open-headset-interconnect-standard/ohis/README.md

# Open-Headset-Interconnect-Standard

An open standard for a common interconnect between headsets and radios.
