open-headset-interconnect-standard/ohis/OHIS Presentation/Open Headset Interconnect Standard-2024.pdf

# Open

# Headset Interconne

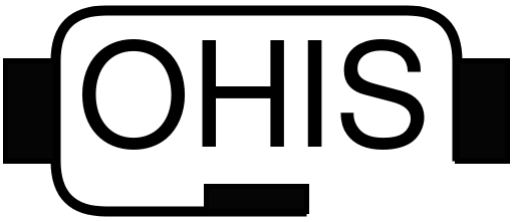
[picture p12: figure]

ct

# Standard

# Mark

Smith,

# N6MTS

https://ohis.org/

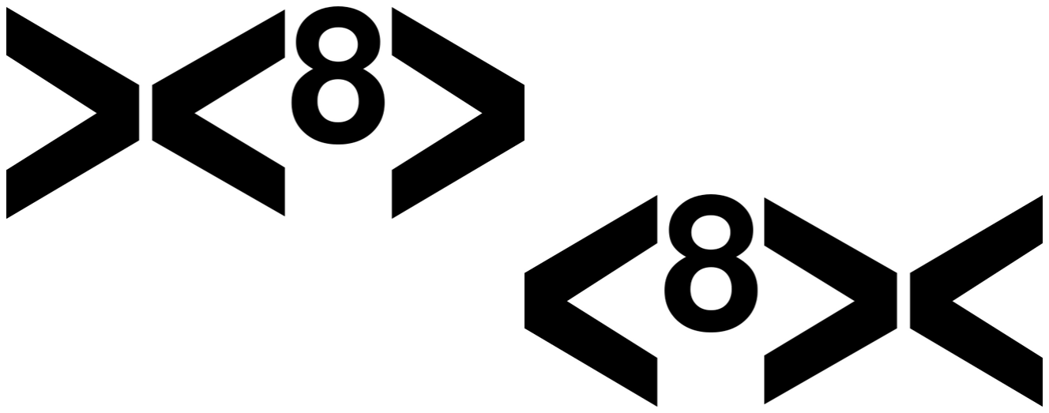
[picture p13: figure]

Video

# Who am I?

### Mark Smith, N6MTS

λ President/CEO, Halibut Electronics: https://electronics.halibut.com/

λ A host of the Ham Radio Workbench Podcast: https://www.hamradioworkbench.com/

λ YouTube: @SmittyHalibut

λ Mastodon/Fediverse: @smitty@halibut.com

Video

# Who am I?

### Mark Smith, N6MTS

λ President/CEO, Halibut Electronics: https://electronics.halibut.com/

λ A host of the Ham Radio Workbench Podcast: https://www.hamradioworkbench.com/

λ YouTube: @SmittyHalibut

λ Mastodon/Fediverse: @smitty@halibut.com

Head Cheese

Video

# Who am I?

λ Ham: Active ham since 1992.

λ College: Two years in Electrical Engineering, but degree in Computer Engineering, CalPoly San Luis Obispo

λ Work: ~30 years in IT, Network and Unix Systems Engineering, and Information Security.

λ All Three: Left IT in 2021, started Halibut Electronics to make Ham Radio and Audiophile electronics.

Video

# Open Headset Interconnect Standard

Video

# Open Headset Interconnect Standard

- Open: Any individual or company may make devices compliant with this standard, with no obligation.

Video

# Open Headset Interconnect Standard

- Open: Any individual or company may make devices compliant with this standard, with no obligation.
- Headset: Describes the signaling commonly found between a user and a radio: Microphone, Headphones, and Push To Talk.

Video

# Open Headset Interconnect Standard

- Open: Any individual or company may make devices compliant with this standard, with no obligation.
- Headset: Describes the signaling commonly found between a user and a radio: Microphone, Headphones, and Push To Talk.
- Interconnect: Describes both the physical and electrical connection of those signals between the user and radio.

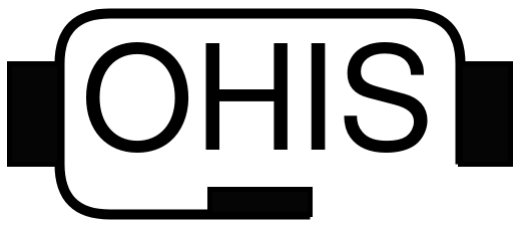
[picture p14: figure]

Video

# Open Headset Interconnect Standard

- Open: Any individual or company may make devices compliant with this standard, with no obligation.
- Headset: Describes the signaling commonly found between a user and a radio: Microphone, Headphones, and Push To Talk.
- Interconnect: Describes both the physical and electrical connection of those signals between the user and radio.
- Standard: Devices built to this standard will work with other devices built to the same standard.

Video

# Electrical Standards

We | have electrical standards (defined, or | de-facto) for
things like RF and Power:

Video

# Electrical Standards

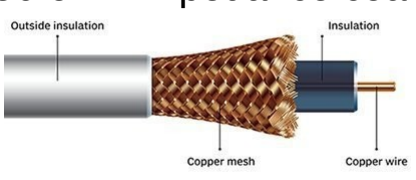
[picture p15: figure]

We | have electrical standards (defined, or | de-facto) for
things like RF and Power:

RF: 50 ohm impedance coax, 450 ohm twin lead

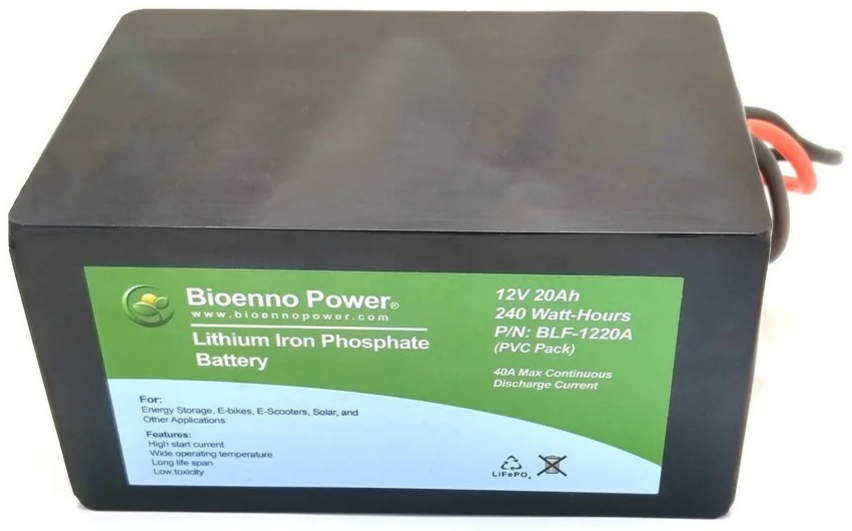
[picture p16: figure]

Video

# Electrical Standards

We | have electrical standards (defined, or | de-facto) for
things like RF and Power:

RF: 50 ohm impedance coax, 450 ohm twin lead

Power: +13.8vDC +/- 15%

Video

# Physical Standards

And one, or a few, physical standards that are easy to convert between:

Video

# Physical Standards

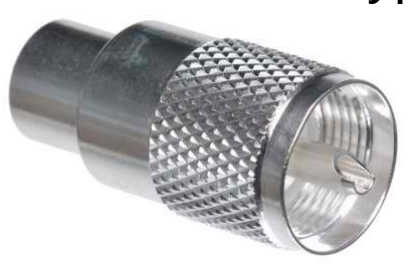
[picture p17: figure]
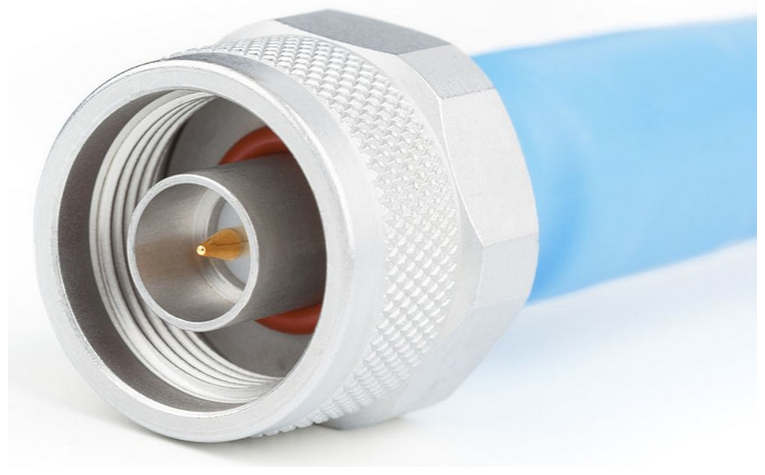
[picture p18: figure]
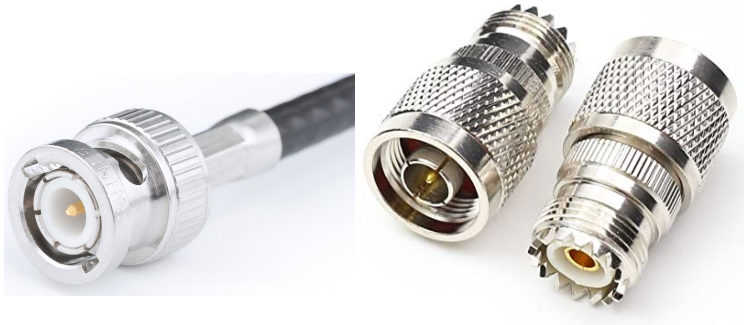
[picture p19: figure]

And one, or a few, physical standards that are easy to convert between:

λ RF: PL-259, Type N, BNC, etc

# Physical Standards

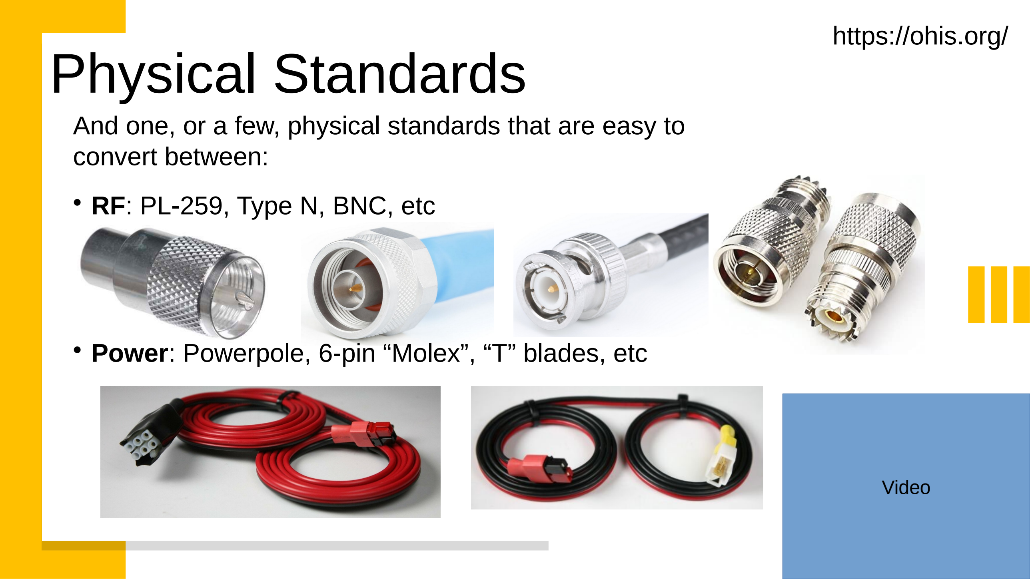
[picture p20: page 15]

Video

And one, or a few, physical standards that are easy to convert between:

λ RF: PL-259, Type N, BNC, etc

λ Power: Powerpole, 6-pin “Molex”, “T” blades, etc

Video

# Headset Standards?

No such electrical standards exist for the User to Radio interface:

Video

# Headset Standards?

No such electrical standards exist for the User to Radio interface:

- Microphone: Dynamic, Electret, or Carbon? Balanced or single ended?

Video

# Headset Standards?

No such electrical standards exist for the User to Radio interface:

- Microphone: Dynamic, Electret, or Carbon? Balanced or single ended?
- Audio out: Line level, headphone level, or speaker level? Ground referenced or push-pull? Mono or stereo?

Video

# Headset Standards?

No such electrical standards exist for the User to Radio interface:

- Microphone: Dynamic, Electret, or Carbon? Balanced or single ended?
- Audio out: Line level, headphone level, or speaker level? Ground referenced or push-pull? Mono or stereo?
- PTT: GPIO style contact closure to ground, or completing the mic circuit?

Video

# So many to choose from!

There are even more physical options to choose from!

Video

# So many to choose from!

There are even more physical options to choose from!

- Microphone: 3.5mm TS? TRS? XLR? “8-pin round?” RJ-45? What’s the pinout?

Video

# So many to choose from!

There are even more physical options to choose from!

- Microphone: 3.5mm TS? TRS? XLR? “8-pin round?” RJ-45? What’s the pinout?
- Audio out: 3.5mm TS? TRS? ¼ inch TS? TRS? RCA?

Video

# So many to choose from!

There are even more physical options to choose from!

- Microphone: 3.5mm TS? TRS? XLR? “8-pin round?” RJ-45? What’s the pinout?
- Audio out: 3.5mm TS? TRS? ¼ inch TS? TRS? RCA?
- PTT: On the mic connector? Separate 3.5mm TS?
¼ inch Footswitch?

The problem is...

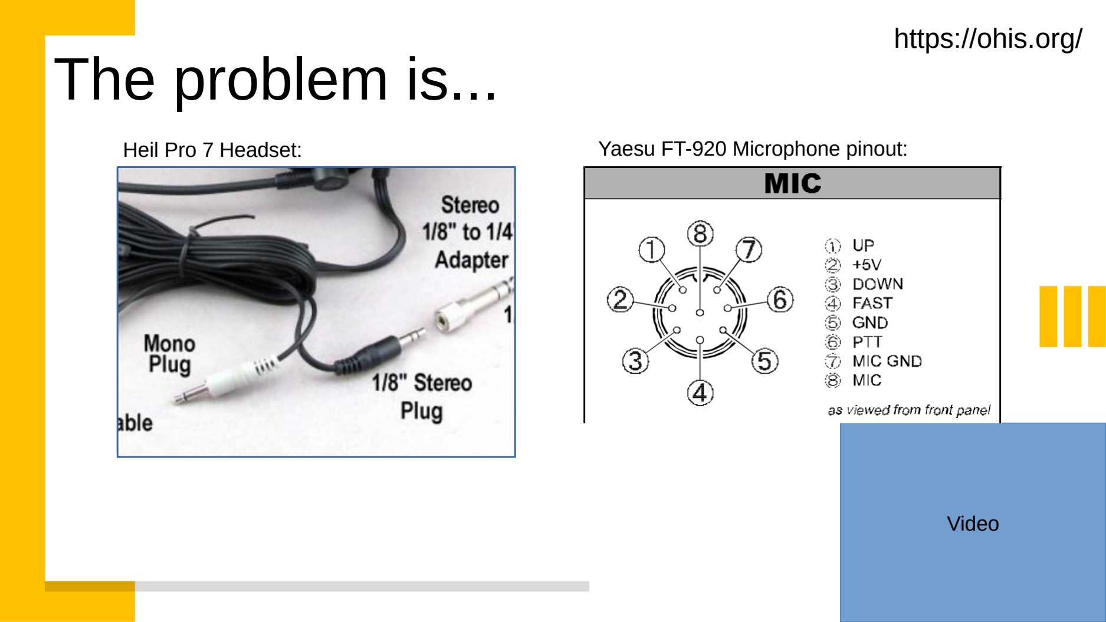
[picture p21: page 24]

Video

Heil Pro 7 Headset: | Yaesu FT-920 Microphone pinout:

# The solution?

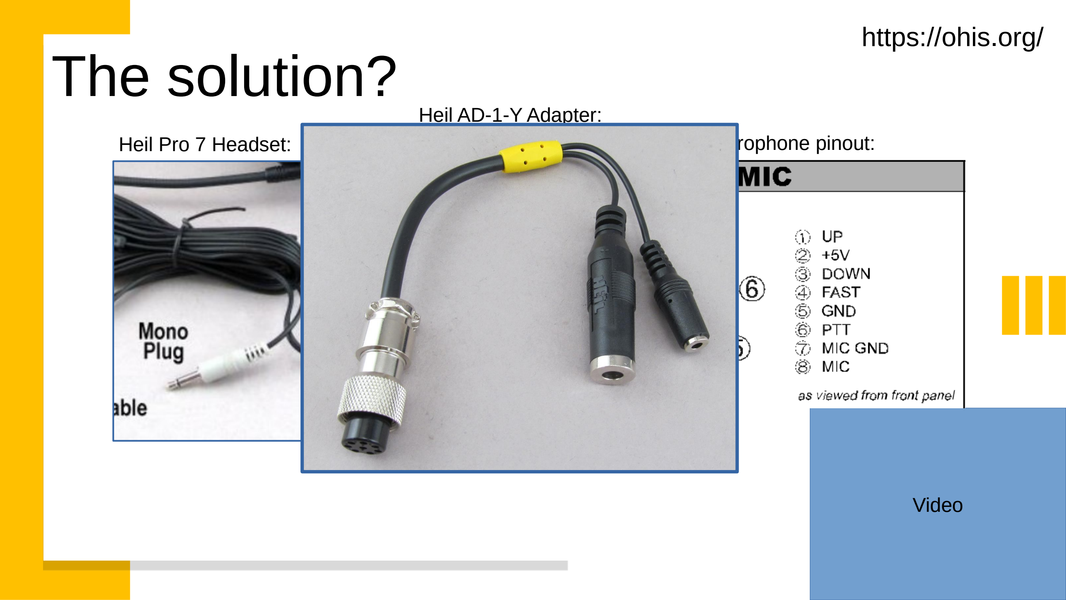
[picture p22: page 25]

Video

Heil AD-1-Y Adapter:

Heil Pro 7 Headset: | Yaesu FT-920 Microphone pinout:

But, I’ve got a Kenwood too.

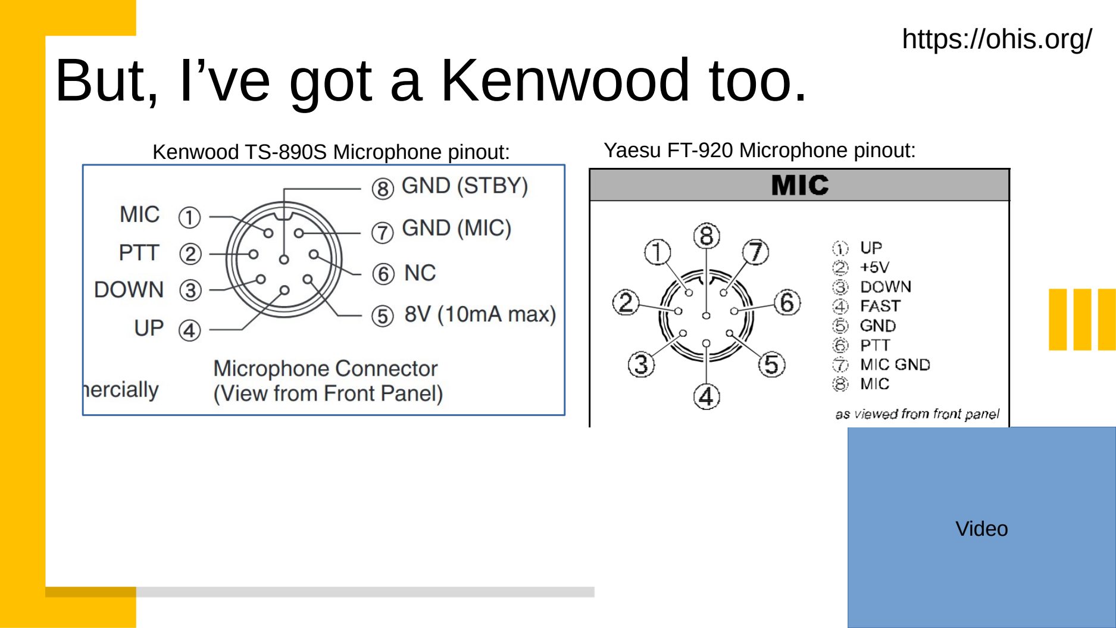
[picture p23: page 26]

Video

Kenwood TS-890S Microphone pinout: | Yaesu FT-920 Microphone pinout:

But, I’ve got a Kenwood too.

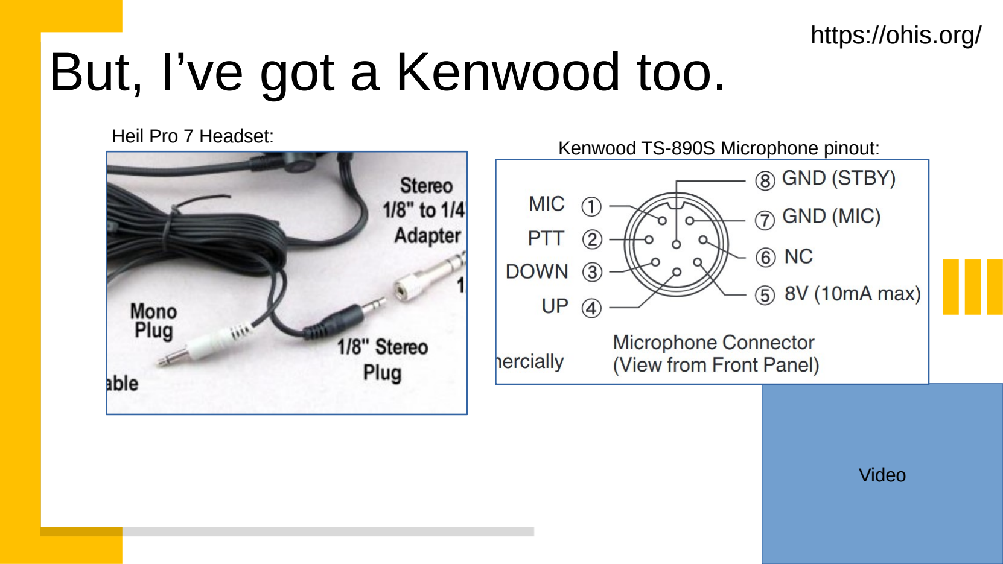
[picture p24: page 27]

Video

Kenwood TS-890S Microphone pinout: Heil Pro 7 Headset:

Bob has me covered...

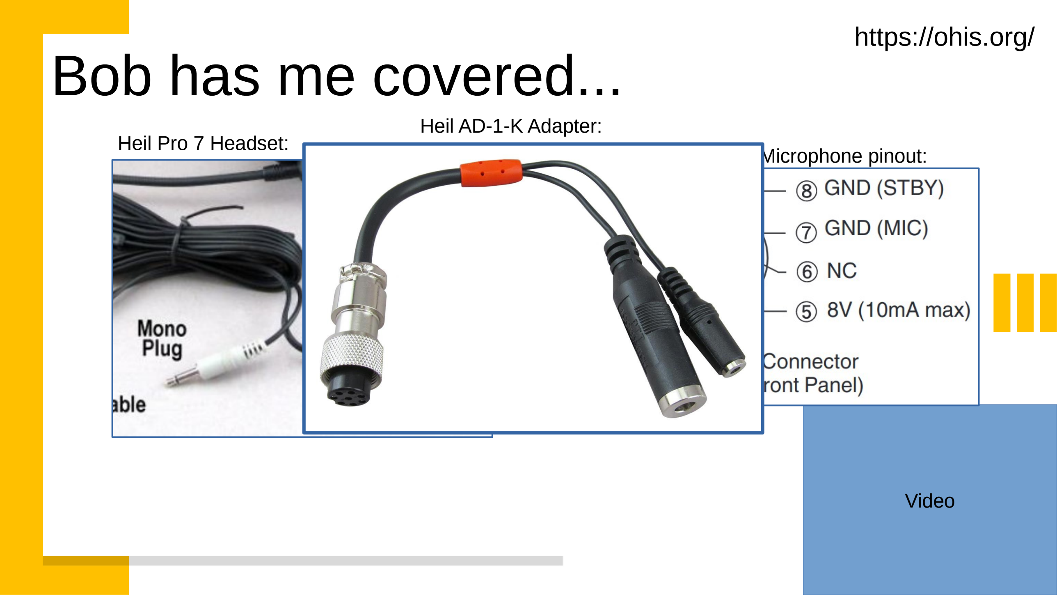
[picture p25: page 28]

Video

Heil Pro 7 Headset: | Kenwood TS-890S Microphone pinout: Heil AD-1-K Adapter:

# What about Icom?

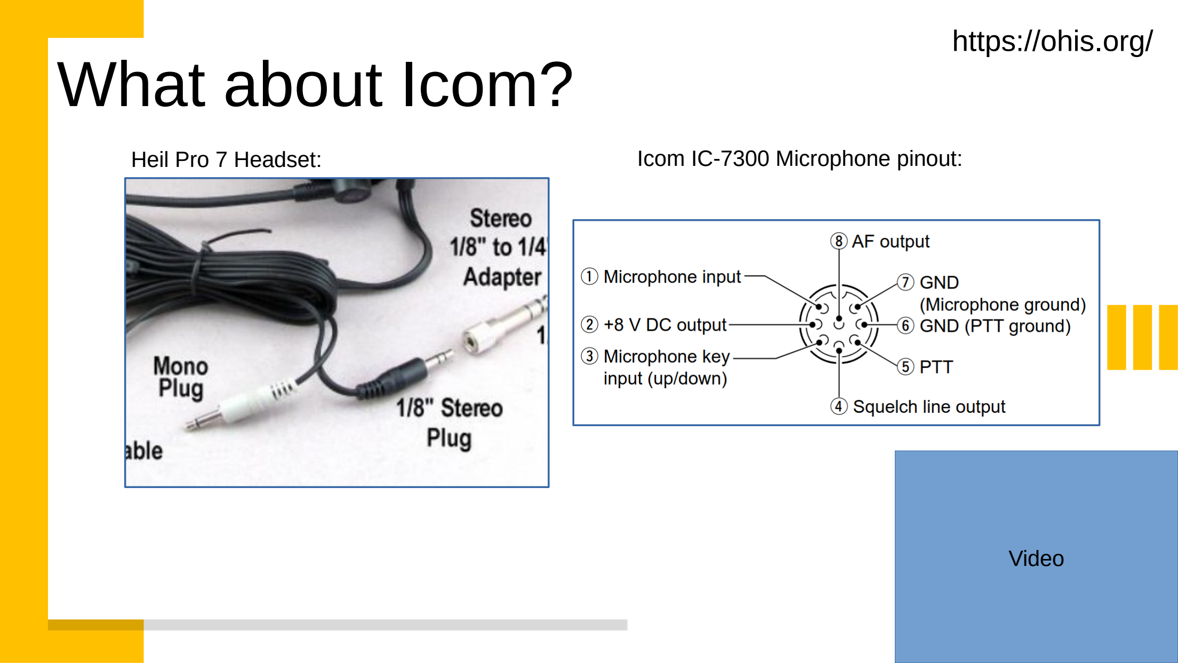
[picture p26: page 29]

Video

Heil Pro 7 Headset: | Icom IC-7300 Microphone pinout:

Same connect-- oh… Never mind...

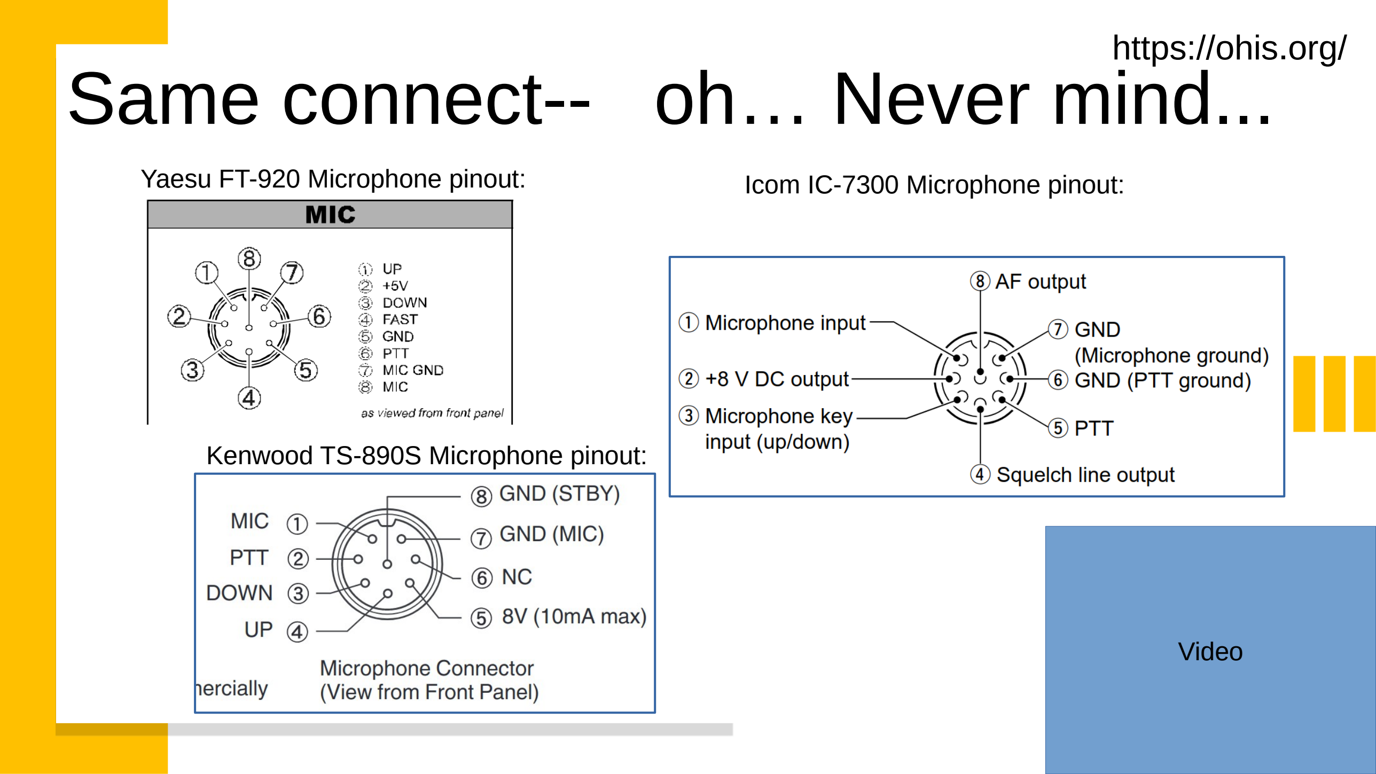
[picture p27: page 30]

Video

Yaesu FT-920 Microphone pinout: | Icom IC-7300 Microphone pinout:

Kenwood TS-890S Microphone pinout:

# What about Icom?

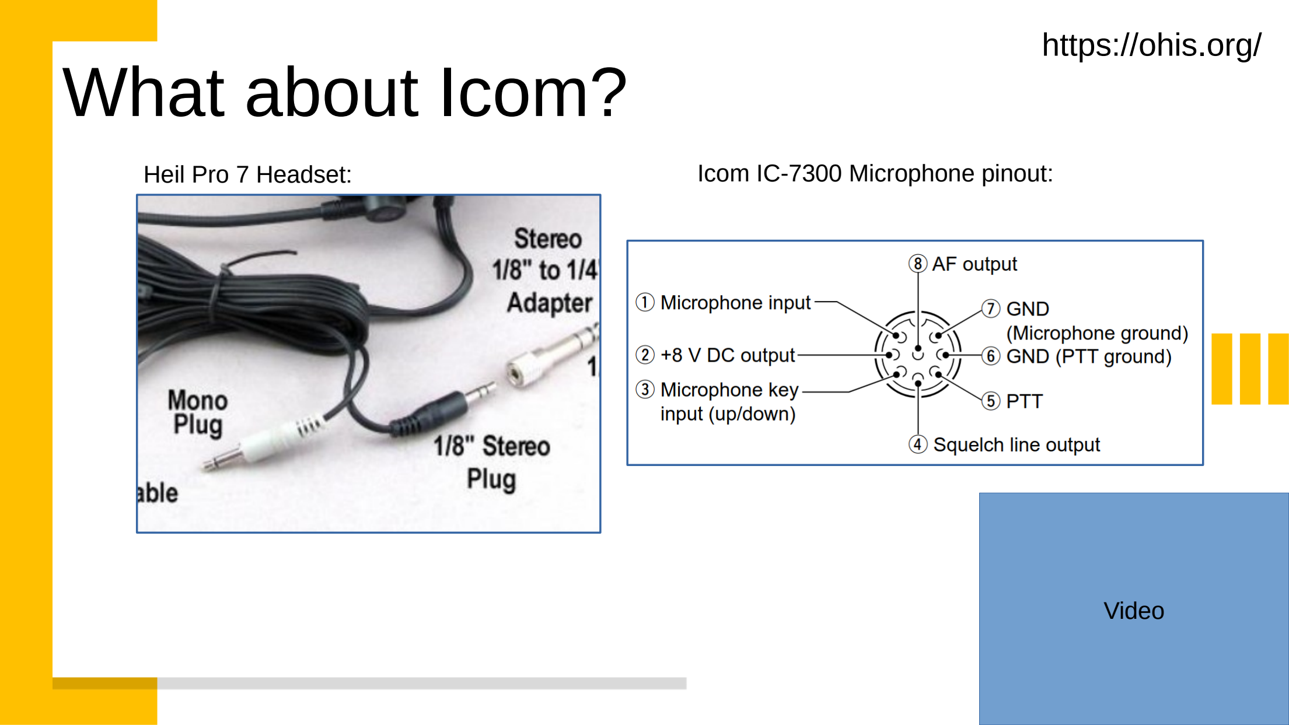
[picture p28: page 31]

Video

Heil Pro 7 Headset: | Icom IC-7300 Microphone pinout:

Bob still has me covered...

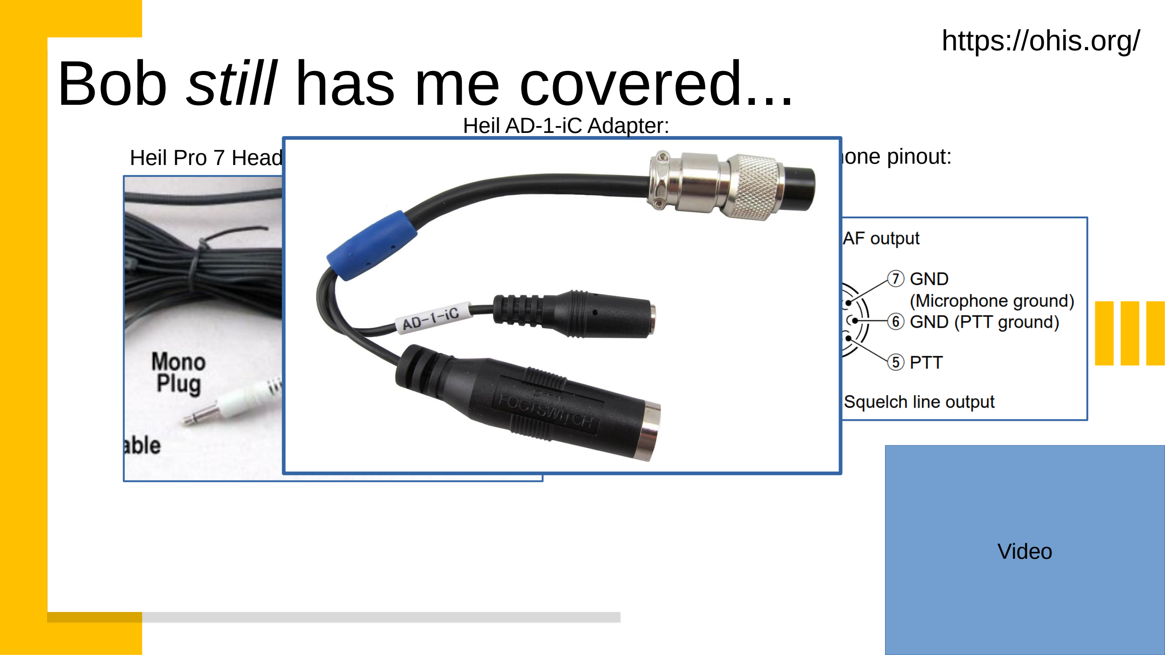
[picture p29: page 32]

Video

Heil Pro 7 Headset: | Icom IC-7300 Microphone pinout: Heil AD-1-iC Adapter:

But, wait a minute...

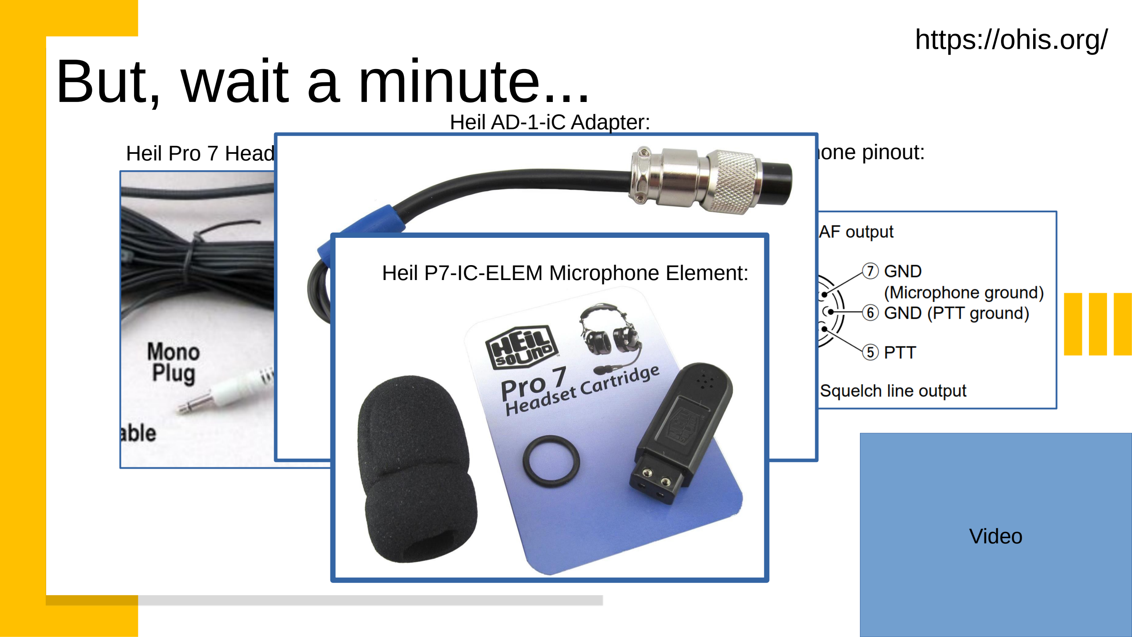
[picture p30: page 33]

Video

Heil Pro 7 Headset: | Icom IC-7300 Microphone pinout: Heil AD-1-iC Adapter:

Heil P7-IC-ELEM Microphone Element:

Video

Another headset,

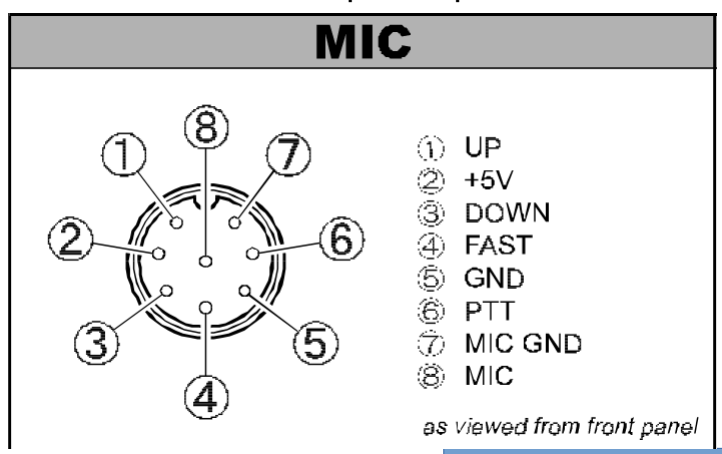
[picture p31: figure]

Yaesu FT-920 Microphone pinout:

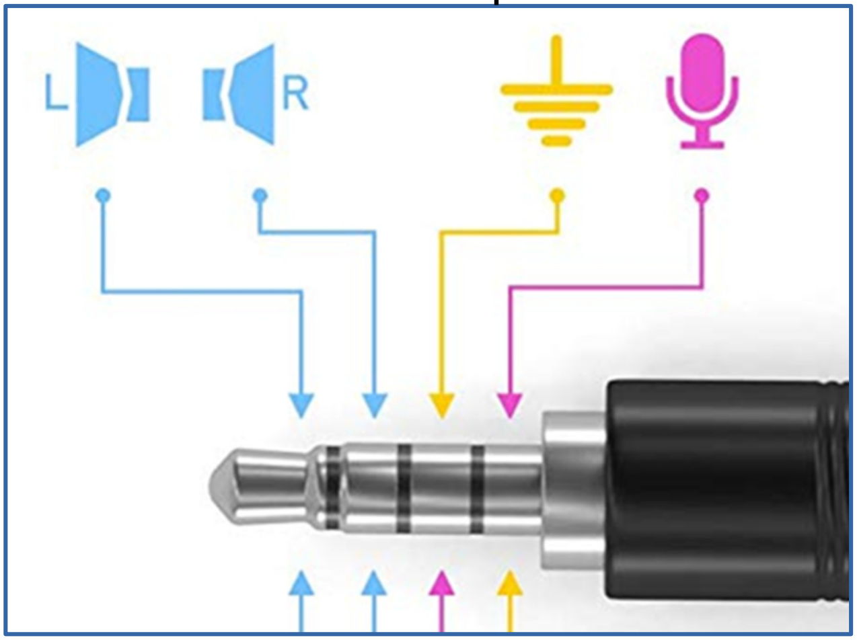
[picture p32: figure]

CTIA “PC Gaming Headset”
or “Mobile Phone” pinout:

Another headset, 3 more adapters...

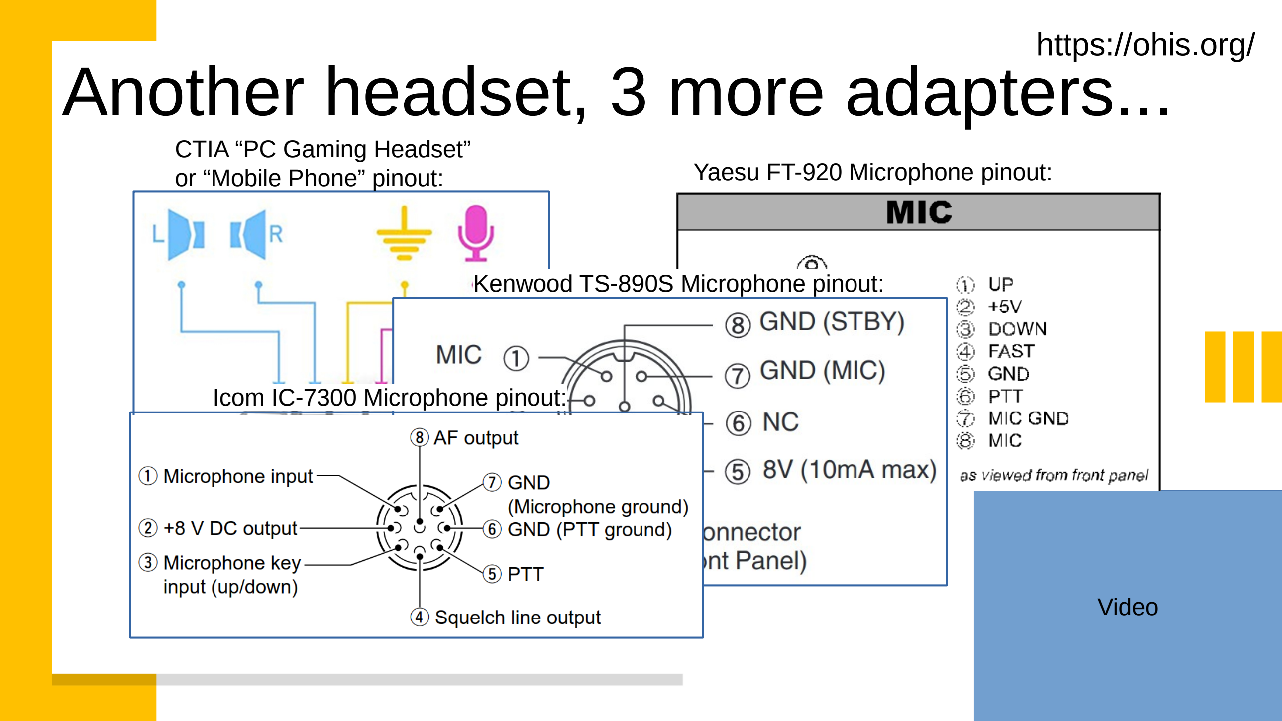
[picture p33: page 35]

Video

Yaesu FT-920 Microphone pinout:

CTIA “PC Gaming Headset”
or “Mobile Phone” pinout:

Kenwood TS-890S Microphone pinout:

Icom IC-7300 Microphone pinout:

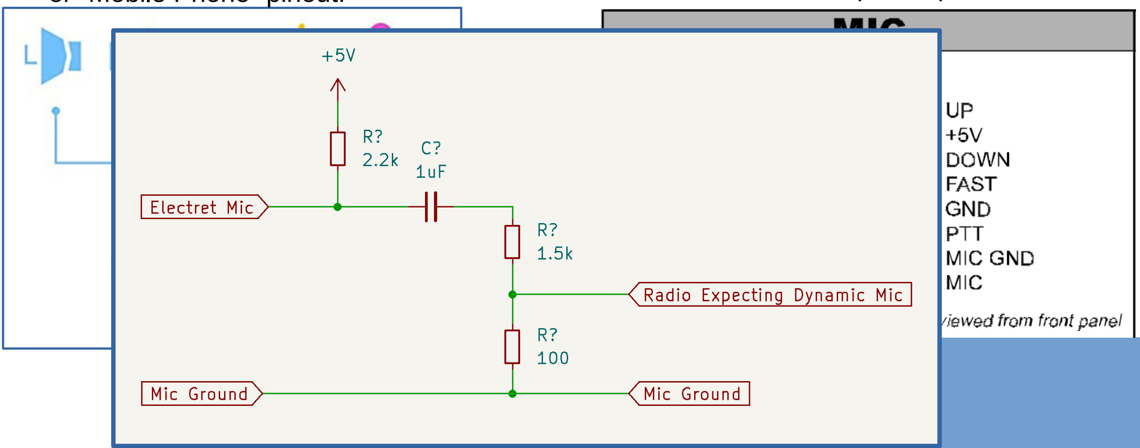
[picture p34: figure]

Video

# “Your audio is distorted!”

Yaesu FT-920 Microphone pinout:

CTIA “PC Gaming Headset”
or “Mobile Phone” pinout:

Video

Your Adapter Game is strong.

This is quickly getting out of hand.

It’s a full mesh of adapters, from every different headset to every different radio.

Video

Your Adapter Game is strong.

This is quickly getting out of hand.

It’s a full mesh of adapters, from every different headset to every different radio.

# How do we address this?

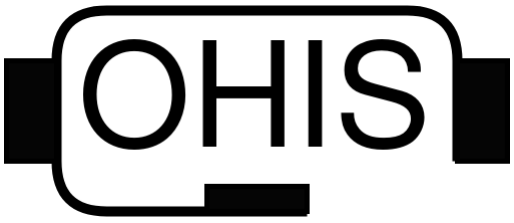
[picture p35: figure]

Video

Your Adapter Game is strong.

This is quickly getting out of hand.

It’s a full mesh of adapters, from every different headset to every different radio.

# How do we address this?

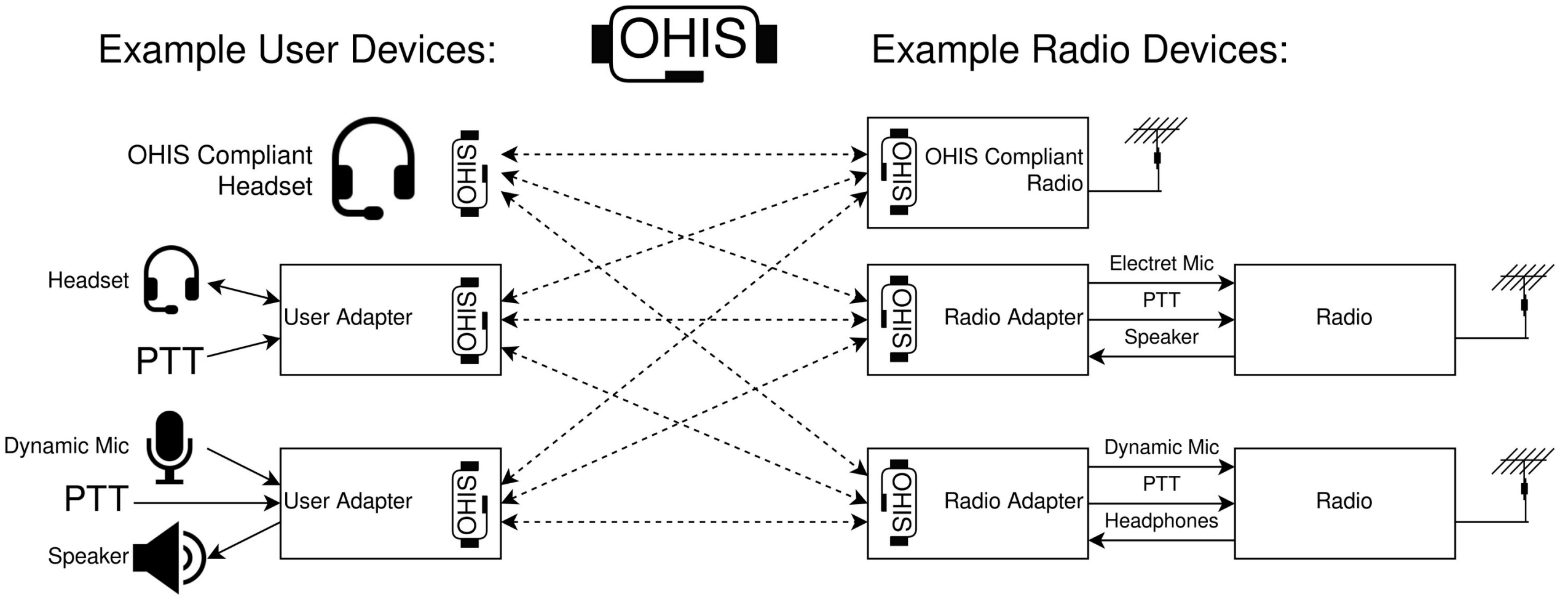
[picture p36: figure]

Video

# Open Headset Interconnect Standard

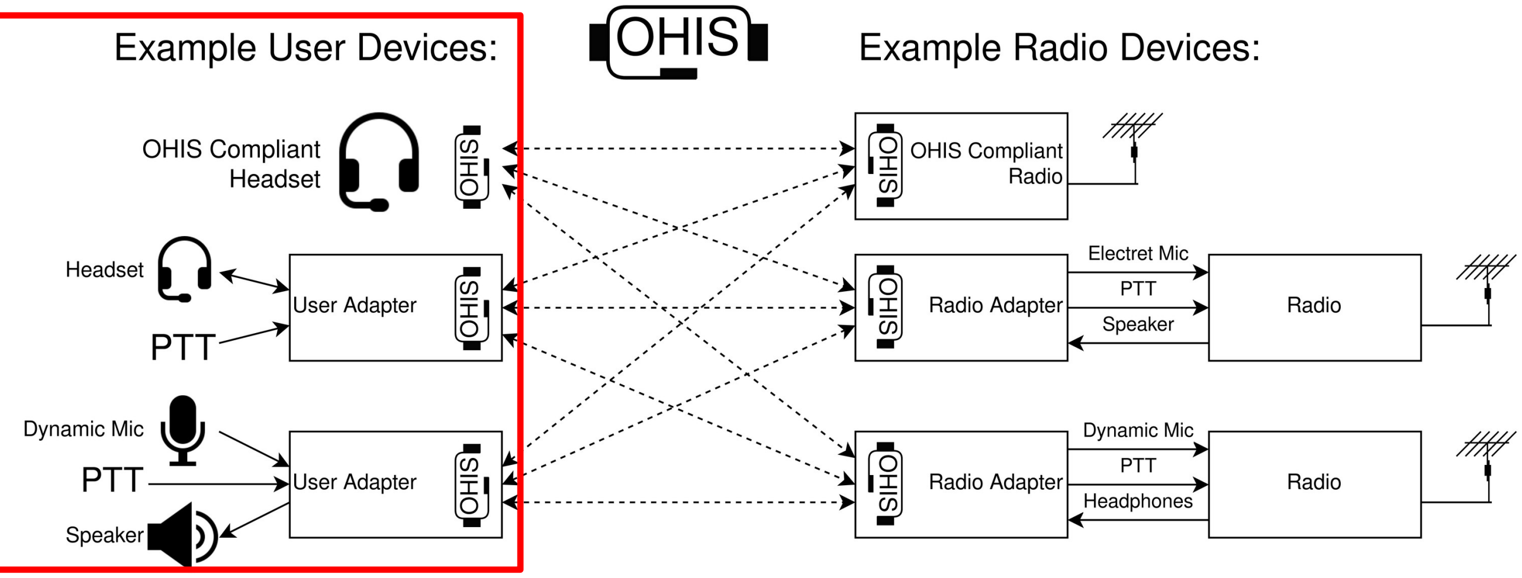
[picture p37: figure]

Video

# Open Headset Interconnect Standard

- User Device/Adapter: Specific to the headset, stays with the headset.

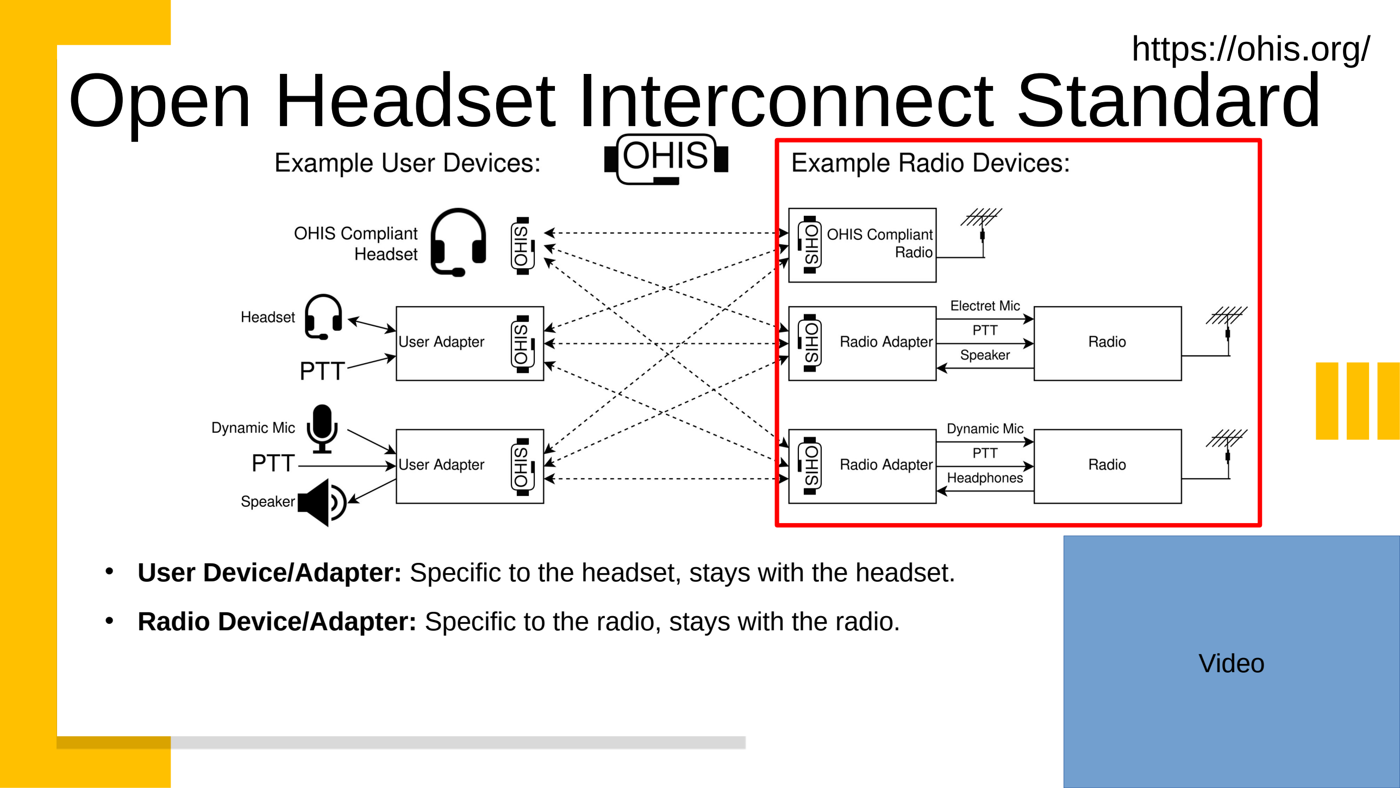
[picture p38: figure]
Video; Open Headset Interconnect Standard

- User Device/Adapter: Specific to the headset, stays with the headset.
- Radio Device/Adapter: Specific to the radio, stays with the radio.

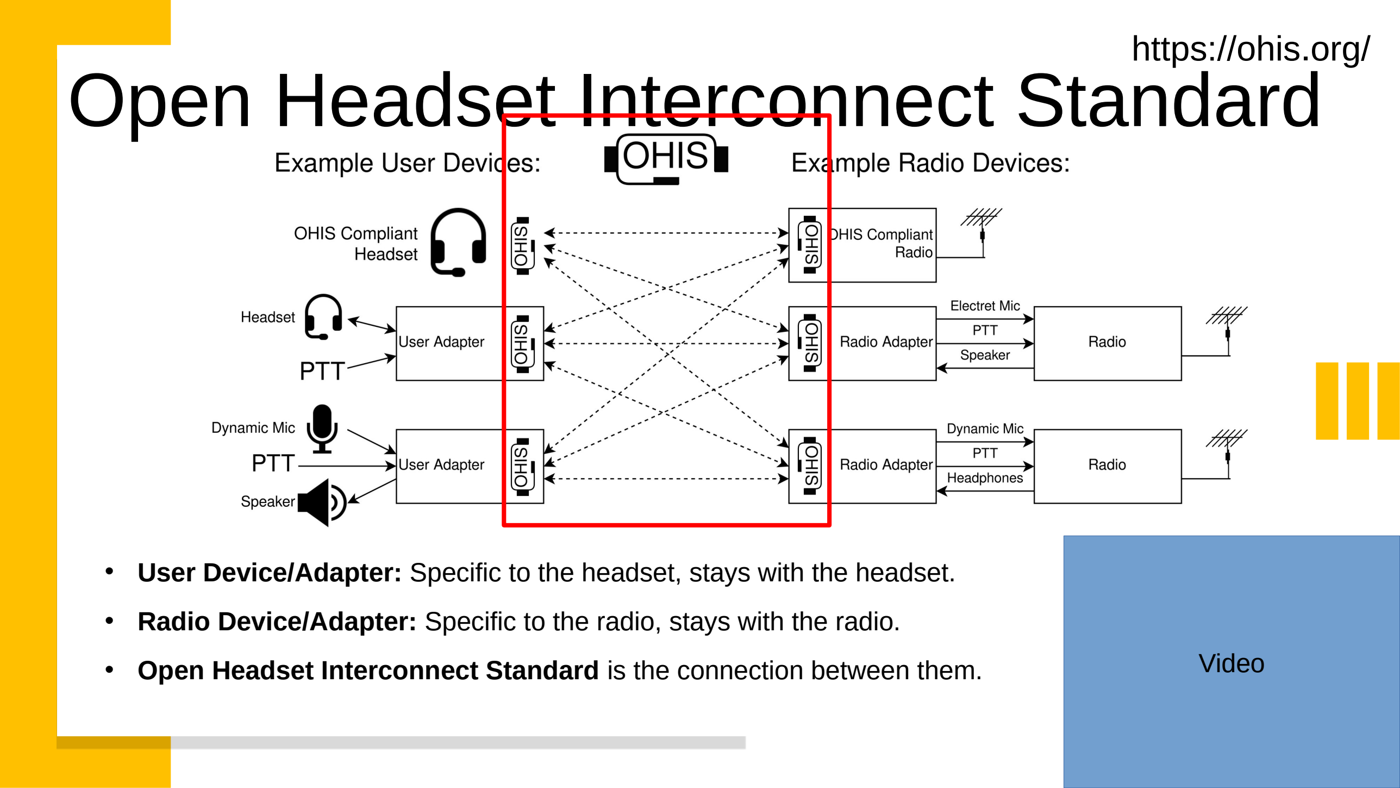
[picture p39: figure]
Video; Open Headset Interconnect Standard

- User Device/Adapter: Specific to the headset, stays with the headset.
- Radio Device/Adapter: Specific to the radio, stays with the radio.
- Open Headset Interconnect Standard is the connection between them.

Video

# Technical Summary

## Electrical:

Video

# Technical Summary

## Electrical:

- Microphone: “Electret” level: -45dBV +/- 3dB, pseudo-balanced. +5vDC bias provided by Radio Device.

Video

# Technical Summary

## Electrical:

- Microphone: “Electret” level: -45dBV +/- 3dB, pseudo-balanced. +5vDC bias provided by Radio Device.
- Audio Out: “Headphone” level: 0dBV full volume, ground referenced, stereo.

Video

# Technical Summary

## Electrical:

- Microphone: “Electret” level: -45dBV +/- 3dB, pseudo-balanced. +5vDC bias provided by Radio Device.
- Audio Out: “Headphone” level: 0dBV full volume, ground referenced, stereo.
- PTT: Contact closure to power ground.

Video

# Technical Summary

## Electrical:

- Microphone: “Electret” level: -45dBV +/- 3dB, pseudo-balanced. +5vDC bias provided by Radio Device.
- Audio Out: “Headphone” level: 0dBV full volume, ground referenced, stereo.
- PTT: Contact closure to power ground.
- Power: (Optional) +5vDC 200mA provided by Radio for audio amplifiers, LED indicators, signal processing, etc.

Video

# Technical Summary

## Physical:

Video

# Technical Summary

## Physical:

- Connector: 8P8C Modular. (Commonly, but incorrectly,

known as RJ-45.)

Video

# Technical Summary

## Physical:

- Connector: 8P8C Modular. (Commonly, but incorrectly,

known as RJ-45.)

- Cable: Shielded Cat5 (or better).

Video

# Technical Summary

## Physical:

- Connector: 8P8C Modular. (Commonly, but incorrectly,

known as RJ-45.)

- Cable: Shielded Cat5 (or better).
- Wiring: TIA-568A or 568B. Which pins are pairs is

important.

Video

# Technical Summary

## Physical:

- Connector: 8P8C Modular. (Commonly, but incorrectly,

known as RJ-45.)

- Cable: Shielded Cat5 (or better).
- Wiring: TIA-568A or 568B. Which pins are pairs is

important.

Allows the use of common off-the-shelf Ethernet cables.

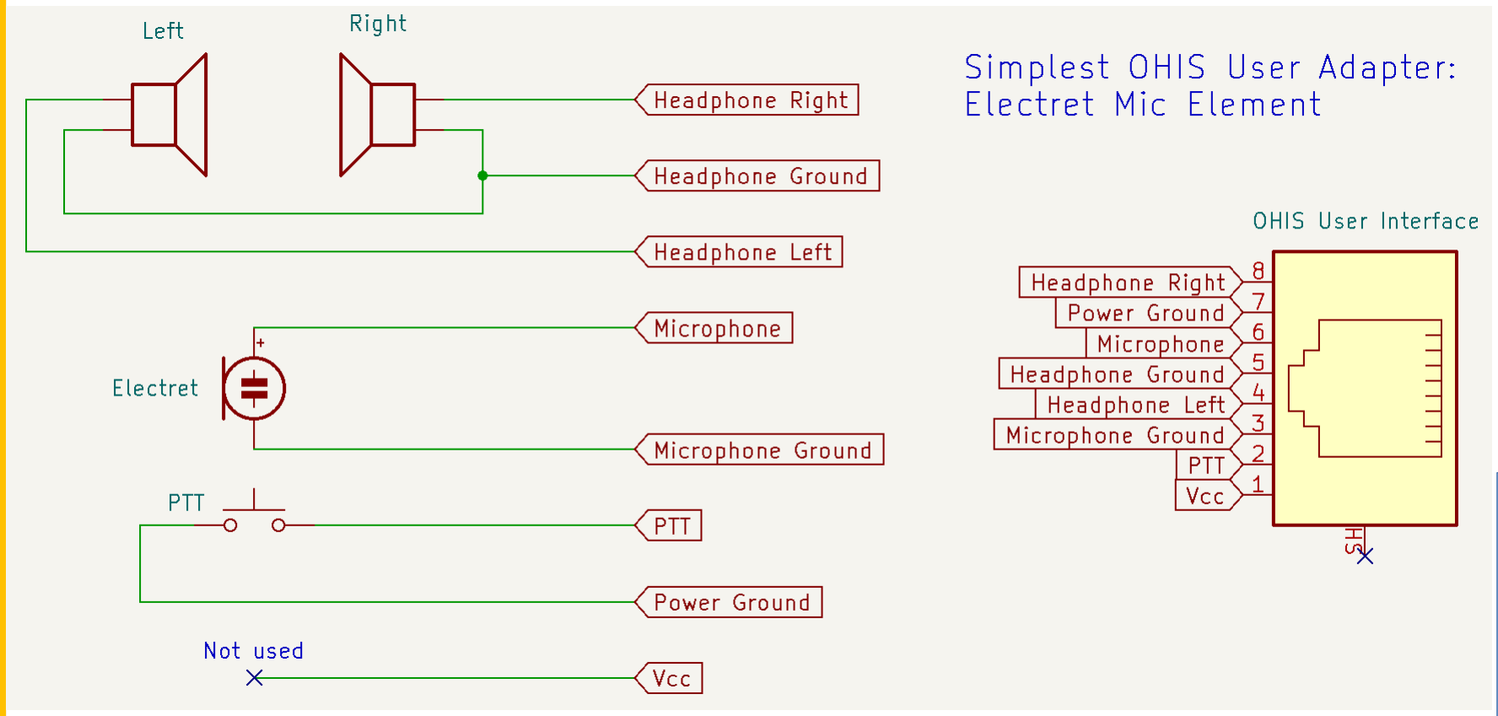
[picture p40: figure]

Video

# Technical Summary

## Pin-out:

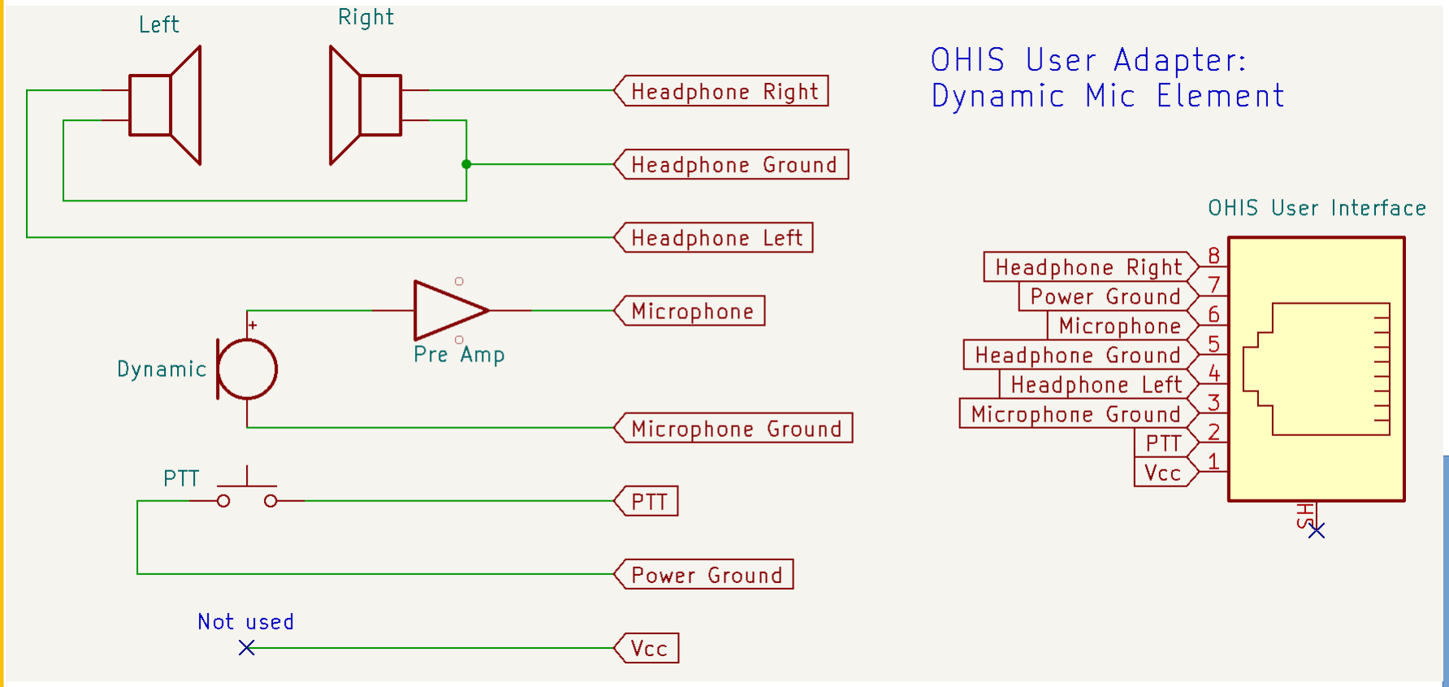
[picture p41: figure]

Video

# Technical Summary

## Pin-out:

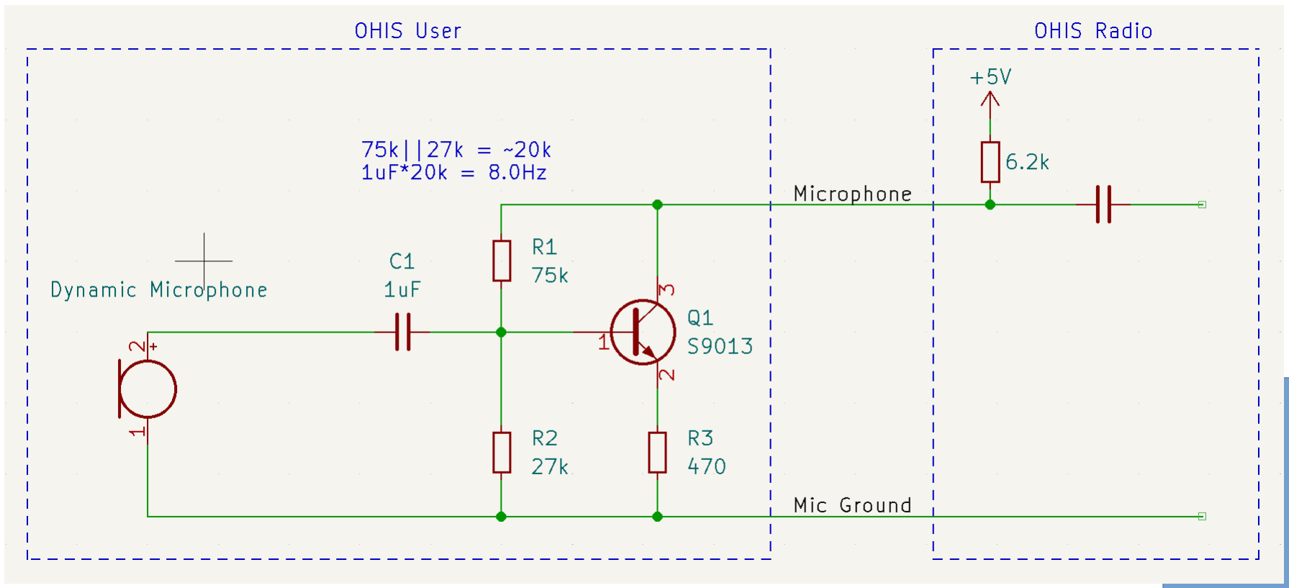
[picture p42: figure]

Video

# Dynamic Mic Pre-Amp

Part of the open standard, freely available for use.

Video

# When is OHIS useful?

Video

# When is OHIS useful?

λ When you have several different radios and headsets.

Video

# When is OHIS useful?

λ When you have several different radios and headsets.

λ When you operate in a multi-user environment and users have their own (different) headsets.

Video

# When is OHIS useful?

λ When you have several different radios and headsets.

λ When you operate in a multi-user environment and users have their own (different) headsets.

λ Examples: Field Day, club shack, or an Emergency Operations Center.

Video

# When is OHIS useful?

λ When you have several different radios and headsets.

λ When you operate in a multi-user environment and users have their own (different) headsets.

λ Examples: Field Day, club shack, or an Emergency Operations Center.

λ To present a common electrical interface for devices between the user and the radio.

Video

# When is OHIS over-kill?

Video

# When is OHIS over-kill?

λ When you only have one radio, or one headset, or any situation where the “full mesh” problem doesn’t apply.

Video

# When is OHIS over-kill?

λ When you only have one radio, or one headset, or any situation where the “full mesh” problem doesn’t apply.

λ When you already have all the adapters you need.

Video

# When is OHIS over-kill?

λ When you only have one radio, or one headset, or any situation where the “full mesh” problem doesn’t apply.

λ When you already have all the adapters you need.

λ When you prefer the simplicity of a single adapter between you and your radio.

Video

# Why an Open Standard?

Video

# Why an Open Standard?

λ Open is how we get out of this mess.

Video

# Why an Open Standard?

λ Open is how we get out of this mess.

λ It makes a good DIY project.

Video

# Learn more:

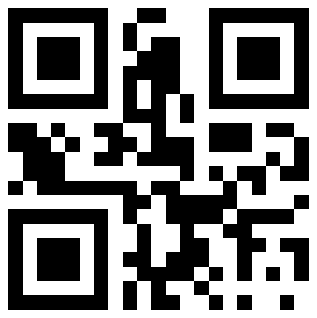
[picture p43: figure]

# https://ohis.org/

# Questions and Answers

# Beginning now

Video

# Slide Title

Slide Content
