open-headset-interconnect-standard/ohis/docs/Open Headset Interconnect Standard - Mark Smith, N6MTS.pdf

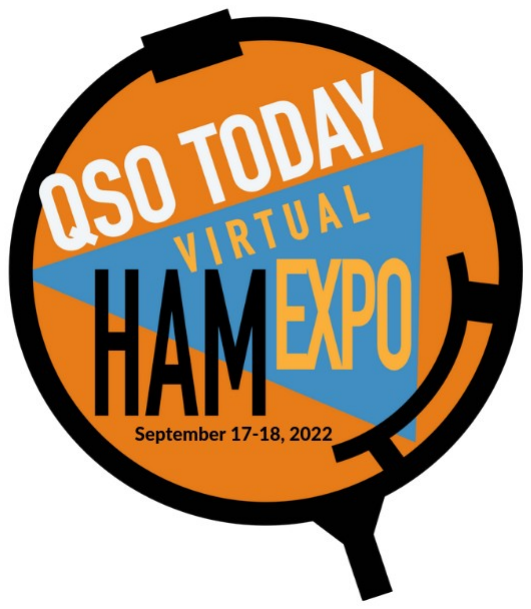
[picture p73: figure]

# Open Headset Interconnect Standard

Mark Smith,

# N6MTS


Video

# Who am I?

### Mark Smith, N6MTS

- Head Cheese, Halibut Electronics: https://electronics.halibut.com/
- A host of the Ham Radio Workbench Podcast: https://www.hamradioworkbench.com/
- Twitter and YouTube: @SmittyHalibut
- Mastodon/Fediverse: @smitty@halibut.com

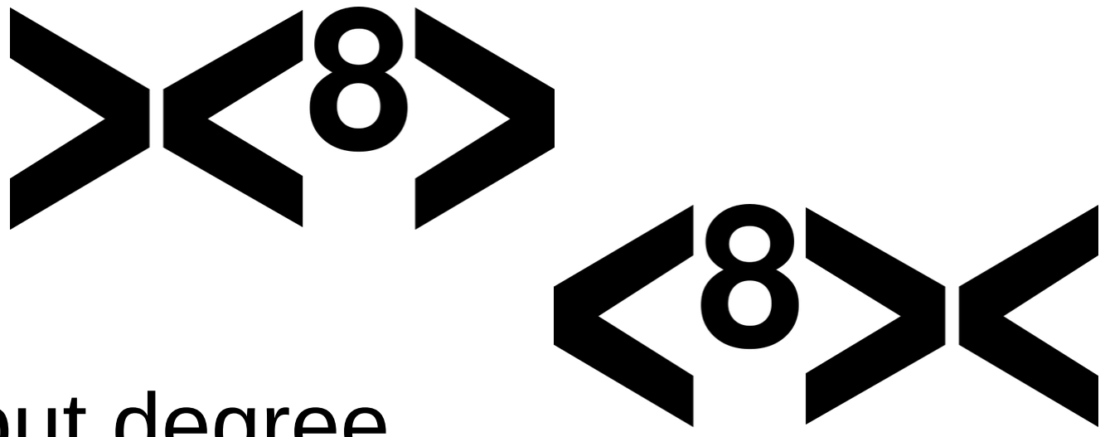
[picture p74: figure]

Video

# Who am I?

- Ham: Active ham since 1992.
- College: Two years in Electrical Engineering, but degree in Computer Engineering
- Work: ~30 years in IT, Network and Unix Systems Engineering, and Information Security.
- All Three: Left IT in 2021, started Halibut Electronics to make Ham Radio and Audiophile electronics.
- First big product, SOAR: Satellite Optimized Amateur Radio. Available late 2022.

Video

# Open Headset Interconnect Standard

Video

# Open Headset Interconnect Standard

- Open: Any individual or company may make devices
compliant with this standard, with no obligation.

Video

# Open Headset Interconnect Standard

- Open: Any individual or company may make devices
compliant with this standard, with no obligation.
- Headset: Describes the signaling commonly found between a user and a radio: Microphone, Headphones, and Push To Talk.

Video

# Open Headset Interconnect Standard

- Open: Any individual or company may make devices
compliant with this standard, with no obligation.
- Headset: Describes the signaling commonly found between a user and a radio: Microphone, Headphones, and Push To Talk.
- Interconnect: Describes both the physical and electrical connection of those signals between the user and radio.

Video

# Open Headset Interconnect Standard

- Open: Any individual or company may make devices
compliant with this standard, with no obligation.
- Headset: Describes the signaling commonly found between a user and a radio: Microphone, Headphones, and Push To Talk.
- Interconnect: Describes both the physical and electrical connection of those signals between the user and radio.
- Standard: Devices built to this standard will work with other devices built to the same standard.

Video

# Electrical Standards

We have electrical standards (defined, or defacto) for things like RF and Power:

Video

# Electrical Standards

We have electrical standards (defined, or defacto) for
things | like RF and Power:
- RF: 50 ohm impedance coax, 450 ohm | twin lead



Video

# Electrical Standards

We have electrical standards (defined, or defacto) for
things | like RF and Power:
- RF: 50 ohm impedance coax, 450 ohm | twin lead
- Power: +13.8vDC +/- 15%

Video

# Physical Standards

And one, or a few, physical standards that are easy to convert between:


Video

# Physical Standards

And one, or a few, physical standards that are easy to convert between:

- RF: PL-259, Type N, BNC, etc


# Physical Standards

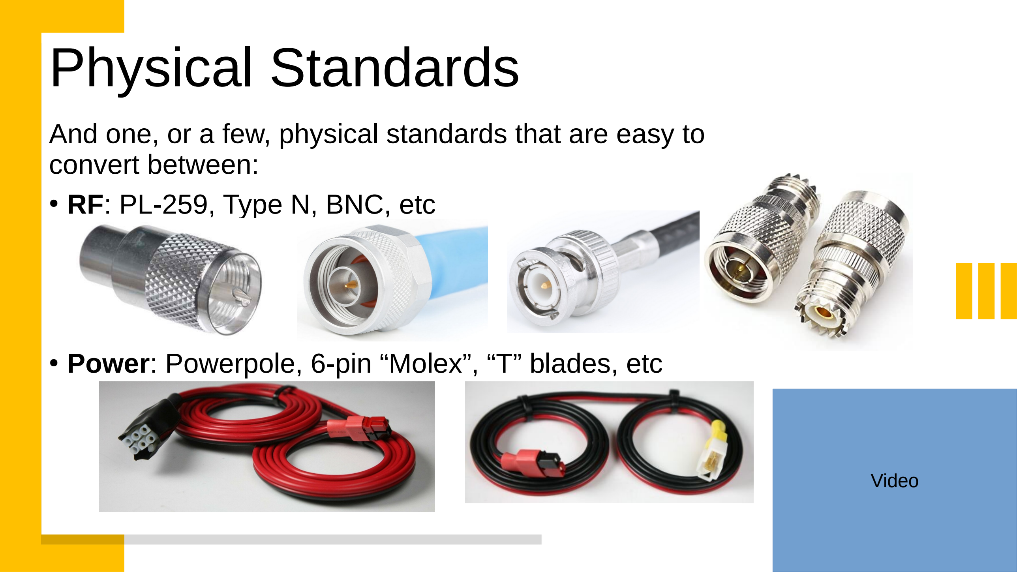
[picture p75: page 14]

Video

And one, or a few, physical standards that are easy to convert between:

- RF: PL-259, Type N, BNC, etc
- Power: Powerpole, 6-pin “Molex”, “T” blades, etc

Video

# Headset Standards?

No such electrical standards exist for the User to Radio interface:

Video

# Headset Standards?

No such electrical standards exist for the User to Radio interface:

- Microphone: Dynamic, Electret, or Carbon? Balanced or single ended?

Video

# Headset Standards?

No such electrical standards exist for the User to Radio interface:

- Microphone: Dynamic, Electret, or Carbon? Balanced or single ended?
- Audio out: Line level, headphone level, or speaker level? Ground referenced or push-pull? Mono or stereo?

Video

# Headset Standards?

No such electrical standards exist for the User to Radio interface:

- Microphone: Dynamic, Electret, or Carbon? Balanced or single ended?
- Audio out: Line level, headphone level, or speaker level? Ground referenced or push-pull? Mono or stereo?
- PTT: GPIO style contact closure to ground, or completing the mic circuit?

Video

So | many to choose from!
There | are even more physical options to | choose from!

Video

So | many to choose from!
There | are even more physical options to | choose from!
- Microphone: 3.5mm TS/TRS? ¼” TS/TRS? XLR? “8-pin round” Aviation? 8 pin modular? 6 pin modular? What pinout?

Video

So | many to choose from!
There | are even more physical options to | choose from!
- Microphone: 3.5mm TS/TRS? ¼” TS/TRS? XLR? “8-pin round” Aviation? 8 pin modular? 6 pin modular? What pinout?
- Audio out: 3.5mm TS/TRS? ¼” TS/TRS? RCA?

Video

So | many to choose from!
There | are even more physical options to | choose from!
- Microphone: 3.5mm TS/TRS? ¼” TS/TRS? XLR? “8-pin round” Aviation? 8 pin modular? 6 pin modular? What pinout?
- Audio out: 3.5mm TS/TRS? ¼” TS/TRS? RCA?
- PTT: On the mic connector? 3.5mm TS? ¼” TS?

The problem is...

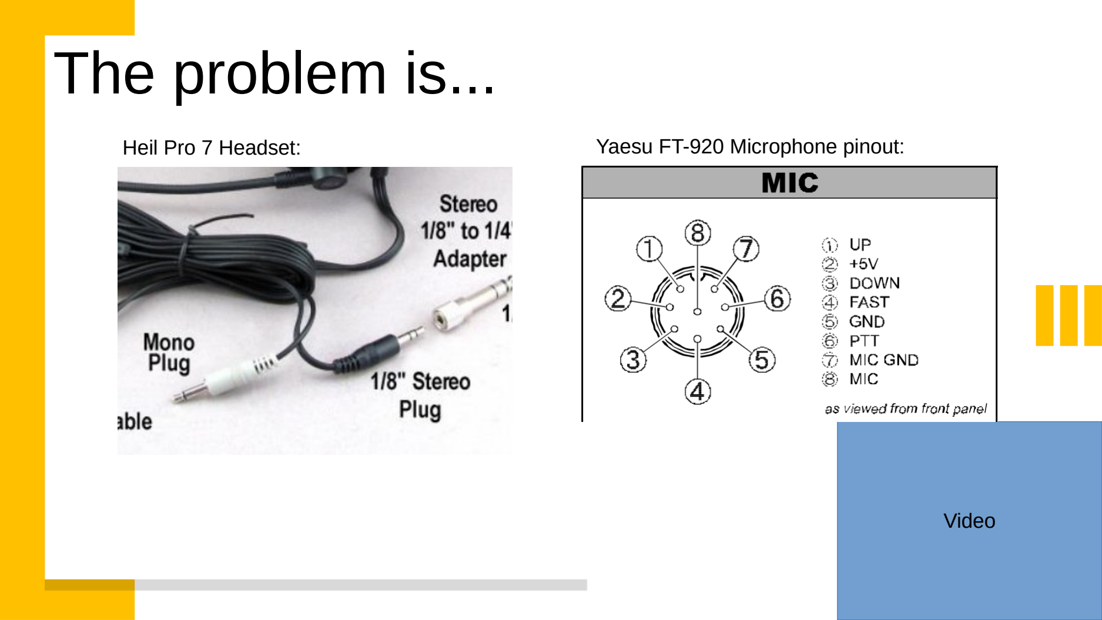
[picture p76: page 23]

Video

Heil Pro 7 Headset: | Yaesu FT-920 Microphone pinout:

# The solution?

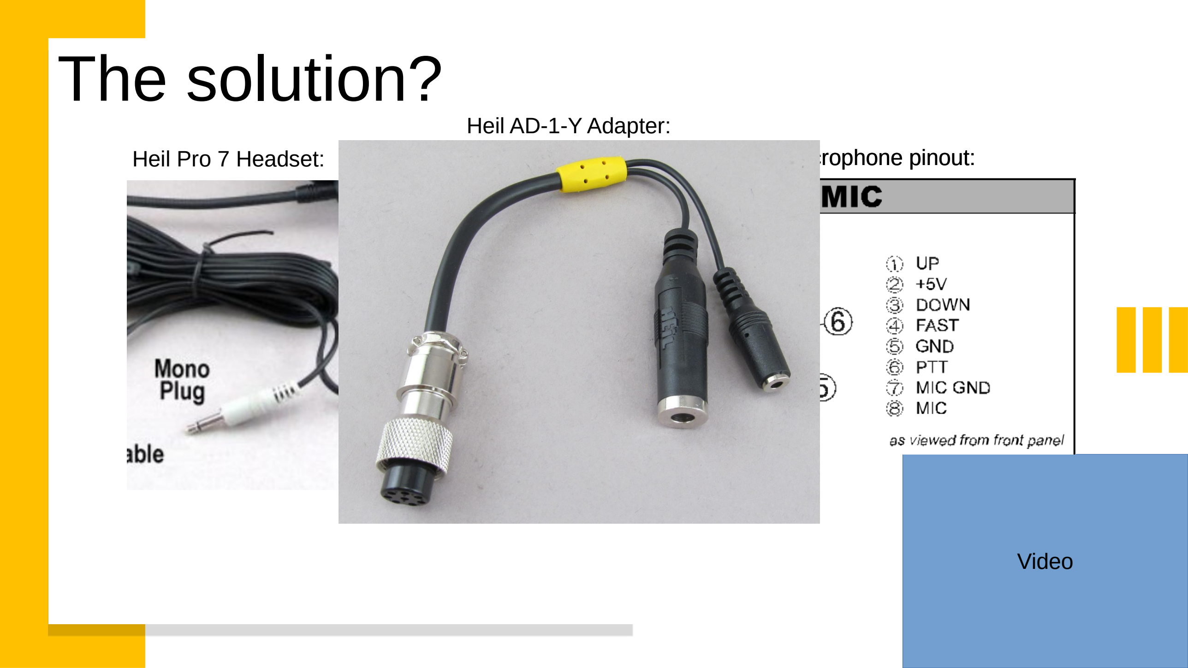
[picture p77: page 24]

Video

Heil AD-1-Y Adapter:

Heil Pro 7 Headset: | Yaesu FT-920 Microphone pinout:

But, I’ve got a Kenwood too.

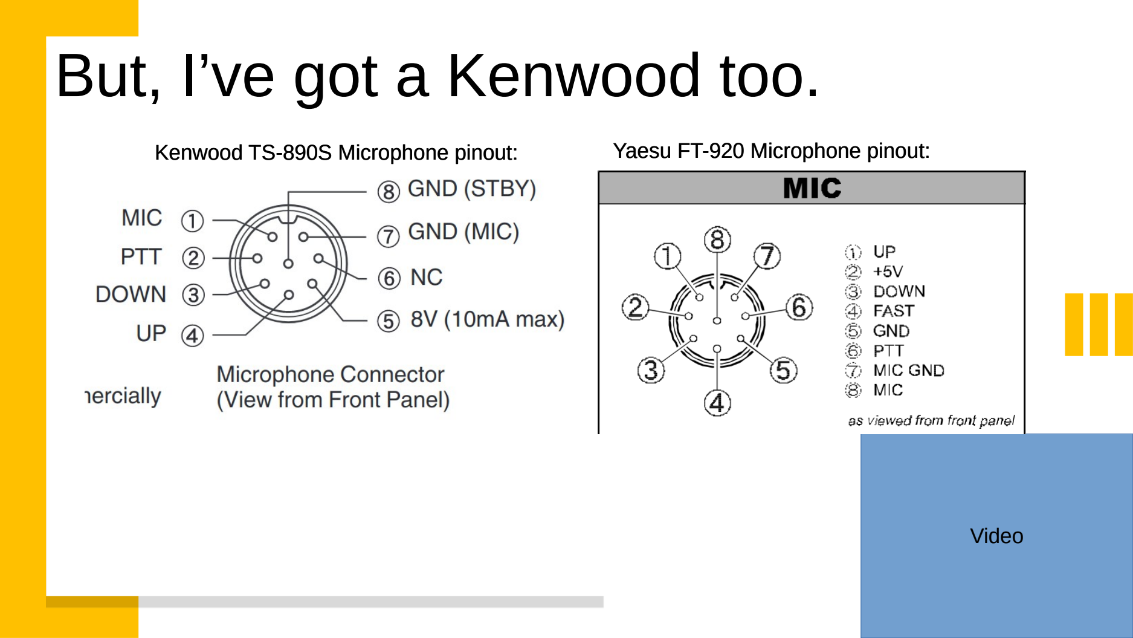
[picture p78: page 25]

Video

Kenwood TS-890S Microphone pinout: | Yaesu FT-920 Microphone pinout:

But, I’ve got a Kenwood too.

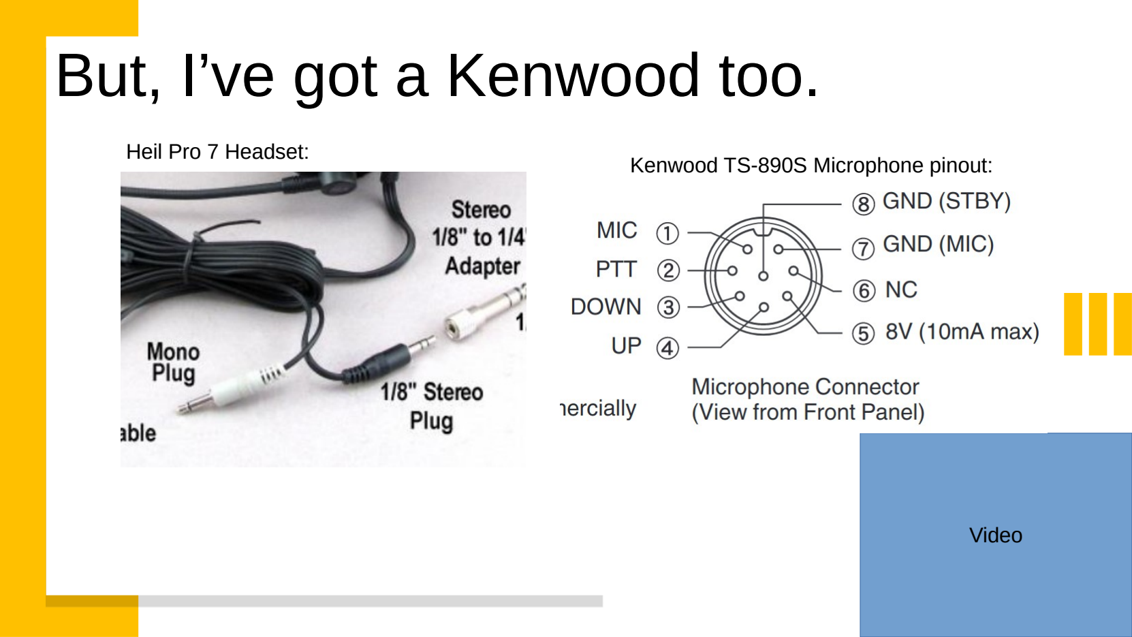
[picture p79: page 26]

Video

Kenwood TS-890S Microphone pinout: Heil Pro 7 Headset:

Bob has me covered...

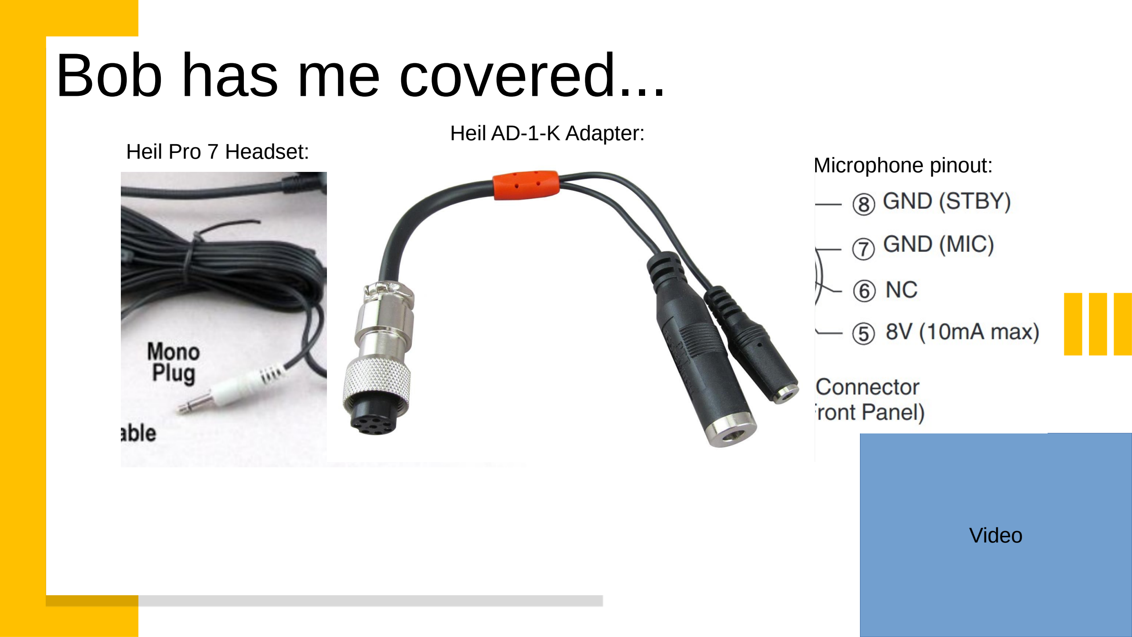
[picture p80: page 27]

Video

Heil Pro 7 Headset: | Kenwood TS-890S Microphone pinout: Heil AD-1-K Adapter:

# What about Icom?

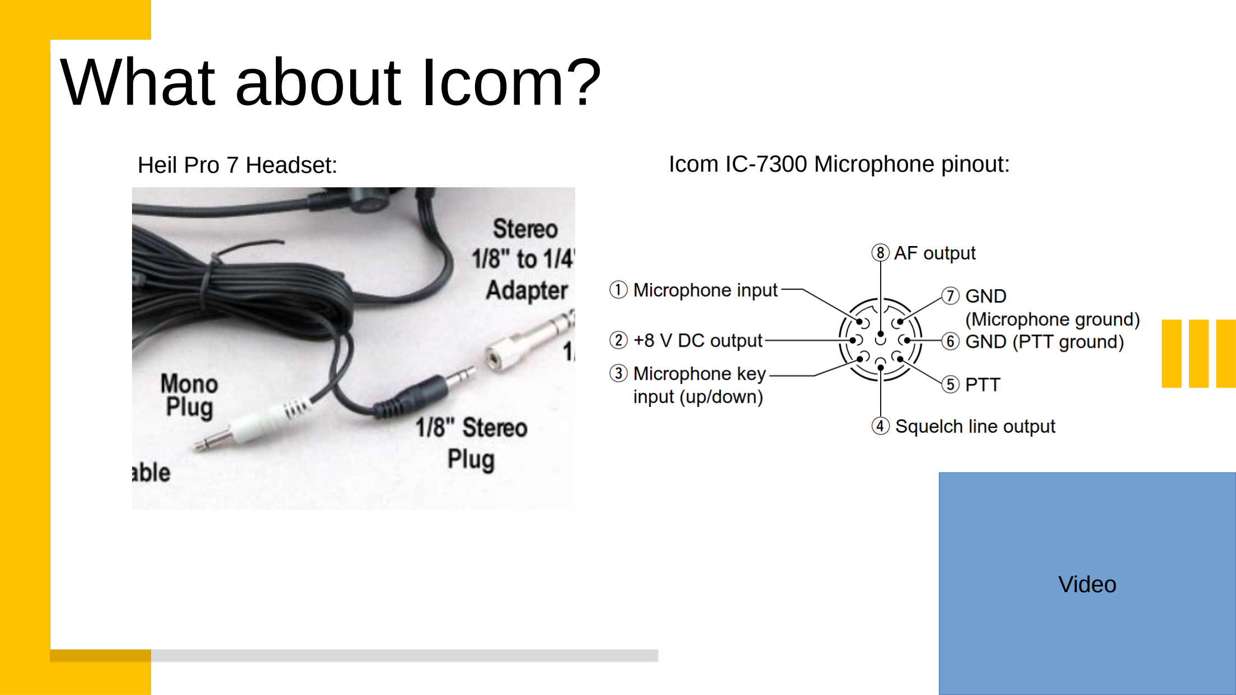
[picture p81: page 28]

Video

Heil Pro 7 Headset: | Icom IC-7300 Microphone pinout:

Same connect-- oh… Never mind...

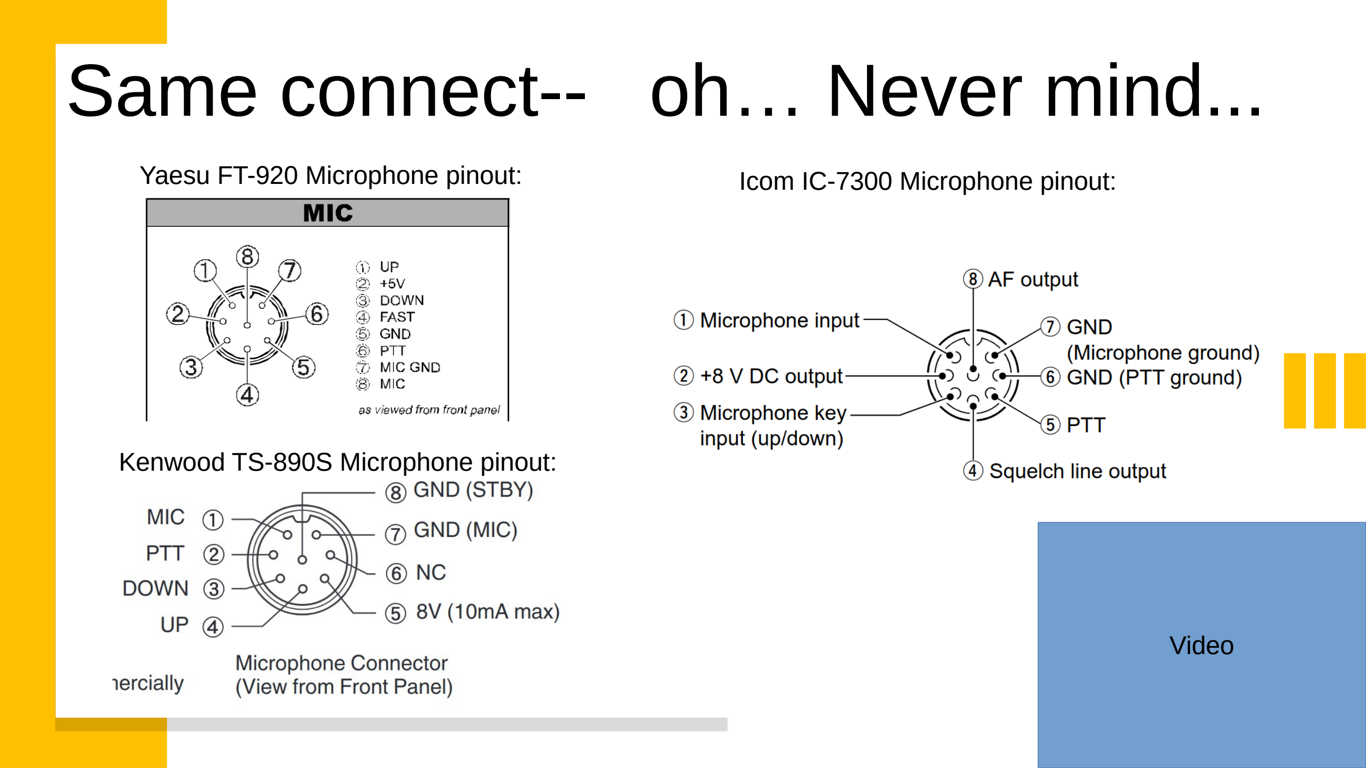
[picture p82: page 29]

Video

Yaesu FT-920 Microphone pinout: | Icom IC-7300 Microphone pinout:

Kenwood TS-890S Microphone pinout:

# What about Icom?

Video

Heil Pro 7 Headset: | Icom IC-7300 Microphone pinout:

Bob still has me covered...

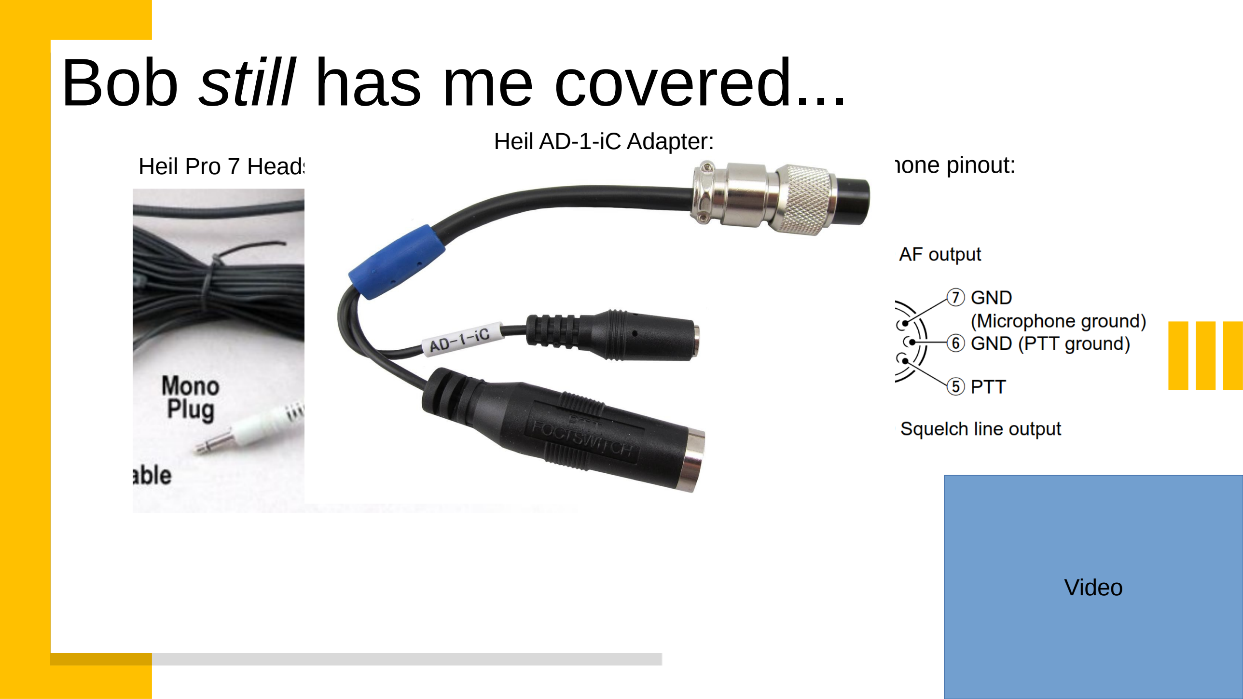
[picture p83: page 31]

Video

Heil Pro 7 Headset: | Icom IC-7300 Microphone pinout: Heil AD-1-iC Adapter:

But, wait a minute...

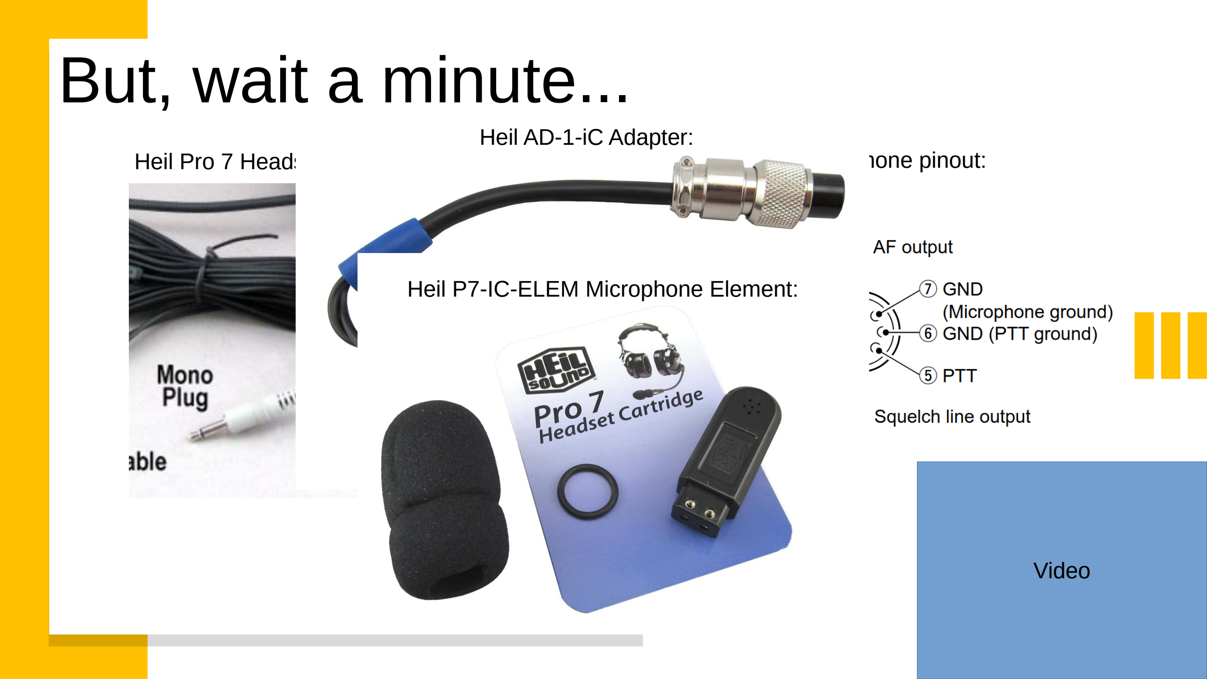
[picture p84: page 32]

Video

Heil Pro 7 Headset: | Icom IC-7300 Microphone pinout: Heil AD-1-iC Adapter:

Heil P7-IC-ELEM Microphone Element:

Video

Another headset,


Yaesu FT-920 Microphone pinout:

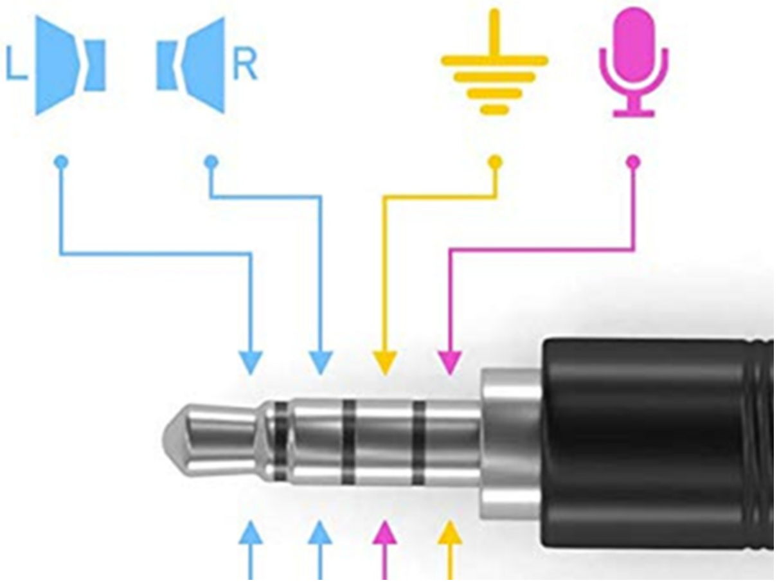
[picture p85: figure]

CTIA “PC Gaming Headset”
or “Mobile Phone” pinout:

Another headset, 3 more adapters...

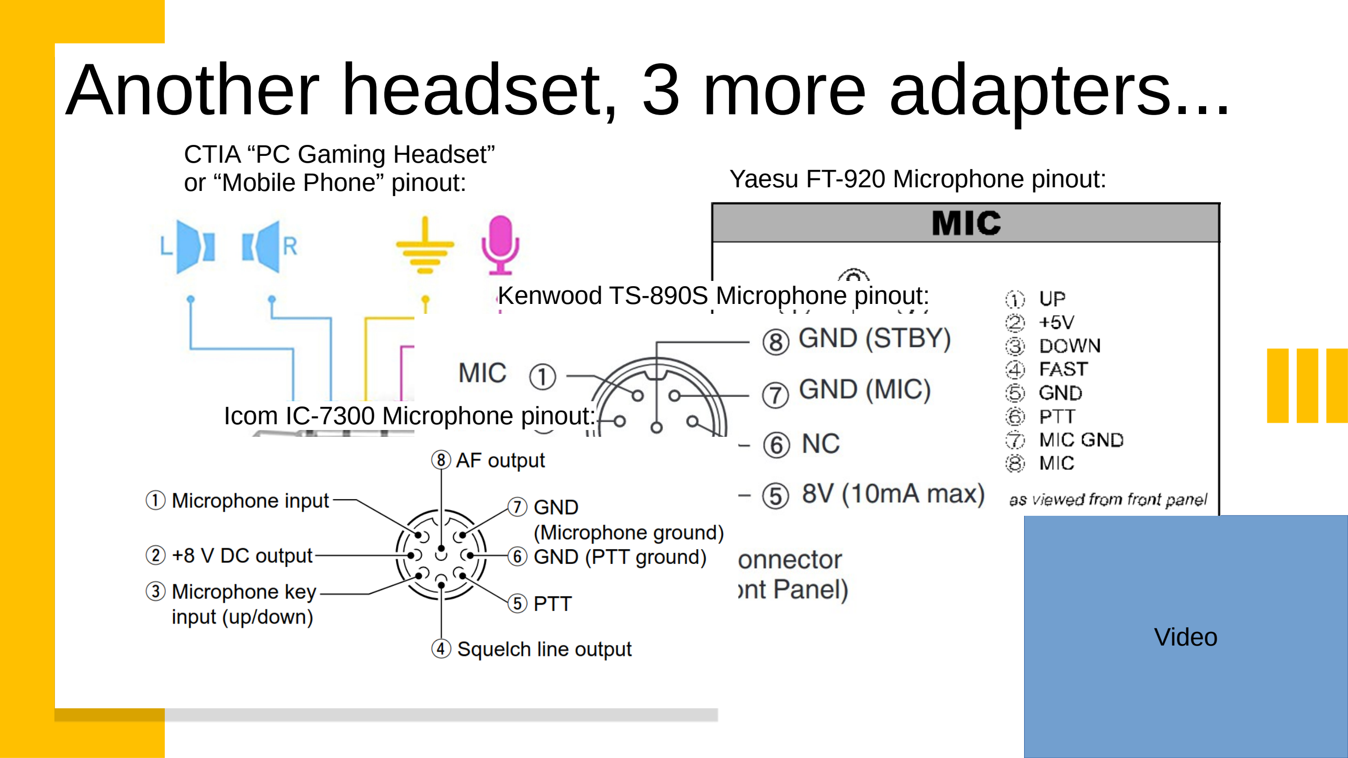
[picture p86: page 34]

Video

Yaesu FT-920 Microphone pinout:

CTIA “PC Gaming Headset”
or “Mobile Phone” pinout:

Kenwood TS-890S Microphone pinout:

Icom IC-7300 Microphone pinout:

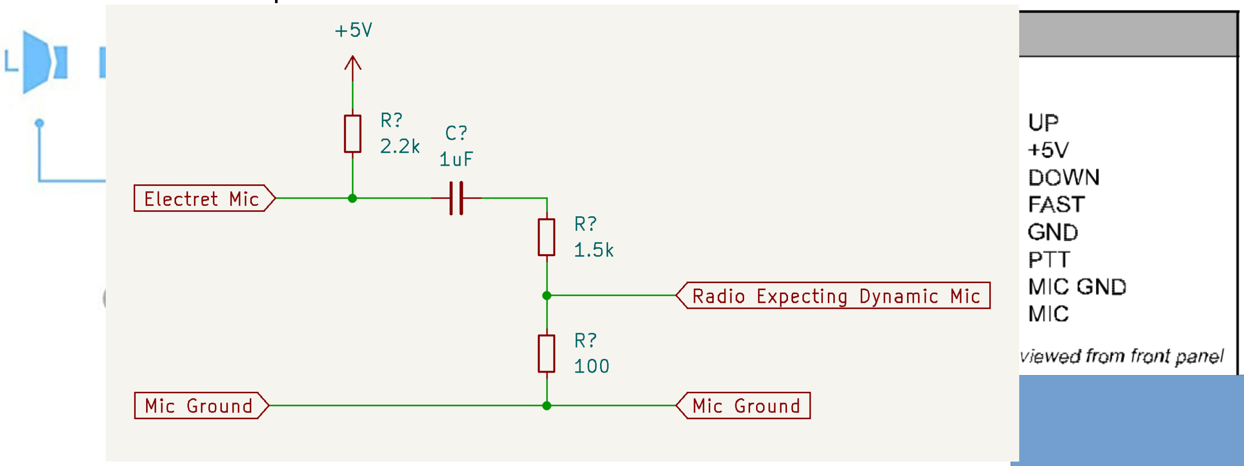
[picture p87: figure]

Video

# “Your audio is distorted!”

Yaesu FT-920 Microphone pinout:

CTIA “PC Gaming Headset”
or “Mobile Phone” pinout:

Video

# Which 3.5mm TRRS was that?

CTIA “PC Gaming Headset”
or “Mobile Phone” pinout:

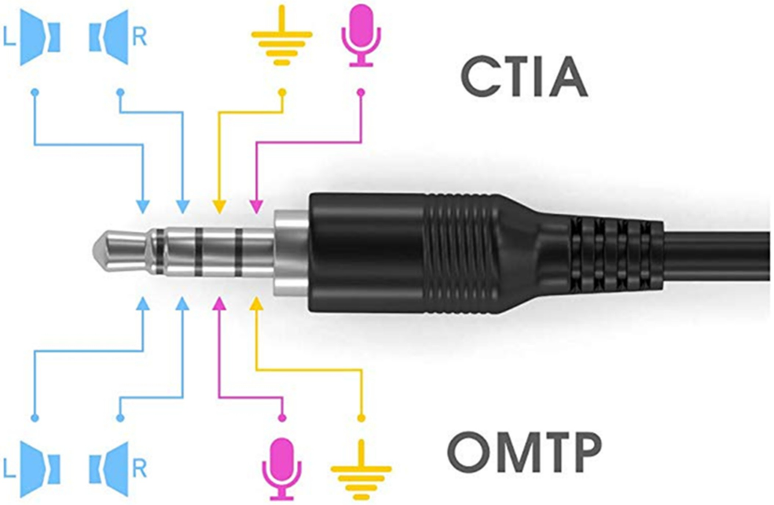
[picture p88: figure]

Video

# Which 3.5mm TRRS was that?

CTIA “PC Gaming Headset”
or “Mobile Phone” pinout:

Video

Your Adapter Game is strong.

This is quickly getting out of hand.

It’s a full mesh of adapters, from every different headset to every different radio.

Video

Your Adapter Game is strong.

This is quickly getting out of hand.

It’s a full mesh of adapters, from every different headset to every different radio.

## How do we address this?

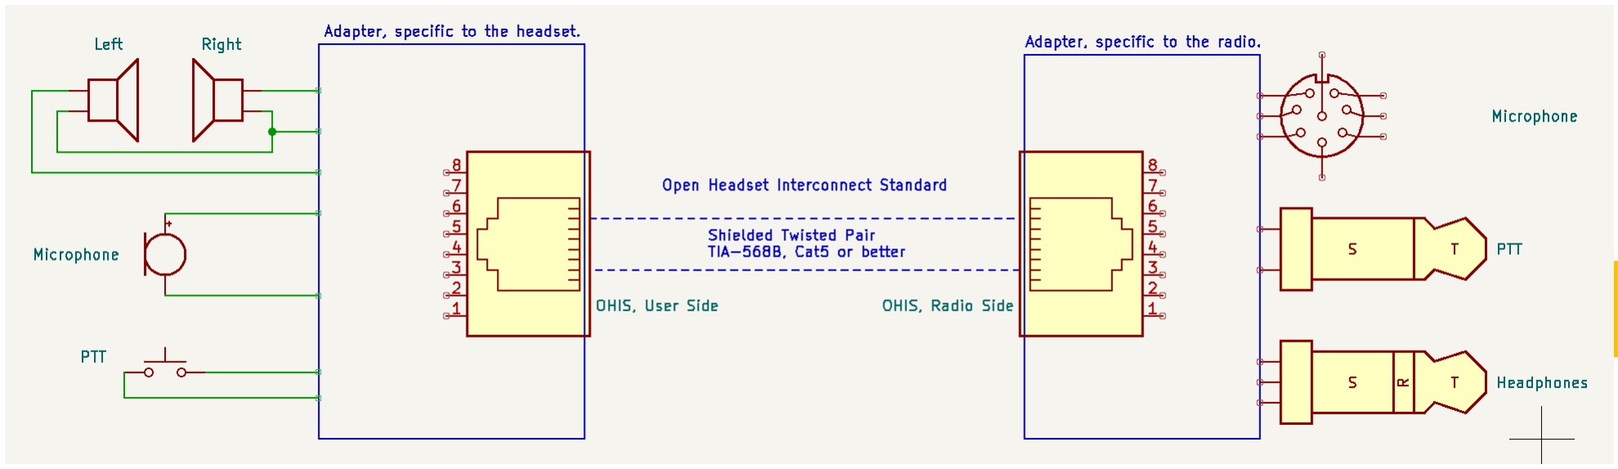
[picture p89: figure]

Video

# Open Headset Interconnect Standard

Video

# Open Headset Interconnect Standard

- | User | side adapter: Specific to the headset, stays with the headset.

Video

# Open Headset Interconnect Standard

- | User | side adapter: Specific to the headset, stays with the headset.
- Radio side adapter: Specific to the radio, stays with the radio.

Video

# Open Headset Interconnect Standard

- | User | side adapter: Specific to the headset, stays with the headset.
- Radio side adapter: Specific to the radio, stays with the radio.
- | Open Headset Interconnect Standard is the connection | between them.

Video

# Technical Summary

## Electrical:

Video

# Technical Summary

## Electrical:

- Microphone: Electret level. +5vDC bias provided by Radio.

Video

# Technical Summary

## Electrical:

- Microphone: Electret level. +5vDC bias provided by Radio.
- Audio Out: Ground referenced, “Headphone” level, stereo.

Video

# Technical Summary

## Electrical:

- Microphone: Electret level. +5vDC bias provided by Radio.
- Audio Out: Ground referenced, “Headphone” level, stereo.
- PTT: Simple contact closure to ground.

Video

# Technical Summary

## Electrical:

- Microphone: Electret level. +5vDC bias provided by Radio.
- Audio Out: Ground referenced, “Headphone” level, stereo.
- PTT: Simple contact closure to ground.
- Power: +5vDC 200mA provided by Radio for audio amplifiers, LED indicators, signal processing, etc.

Video

# Technical Summary

## Physical:

Video

# Technical Summary

## Physical:

- Connector: 8P8C Modular. (Commonly, but incorrectly, known as RJ-45.)

Video

# Technical Summary

## Physical:

- Connector: 8P8C Modular. (Commonly, but incorrectly, known as RJ-45.)
- Cable: Cat5 or better. Shielded is preferred but not required.

Video

# Technical Summary

## Physical:

- Connector: 8P8C Modular. (Commonly, but incorrectly, known as RJ-45.)
- Cable: Cat5 or better. Shielded is preferred but not required.
- Wiring: TIA-568A or 568B. Which pins are pairs is important.

Video

# Technical Summary

## Physical:

- Connector: 8P8C Modular. (Commonly, but incorrectly, known as RJ-45.)
- Cable: Cat5 or better. Shielded is preferred but not required.
- Wiring: TIA-568A or 568B. Which pins are pairs is important.

Allows the use of common off-the-shelf Ethernet cables.


Video

# Technical Summary

## Pin-out:


Video

# Technical Summary

## Pin-out:

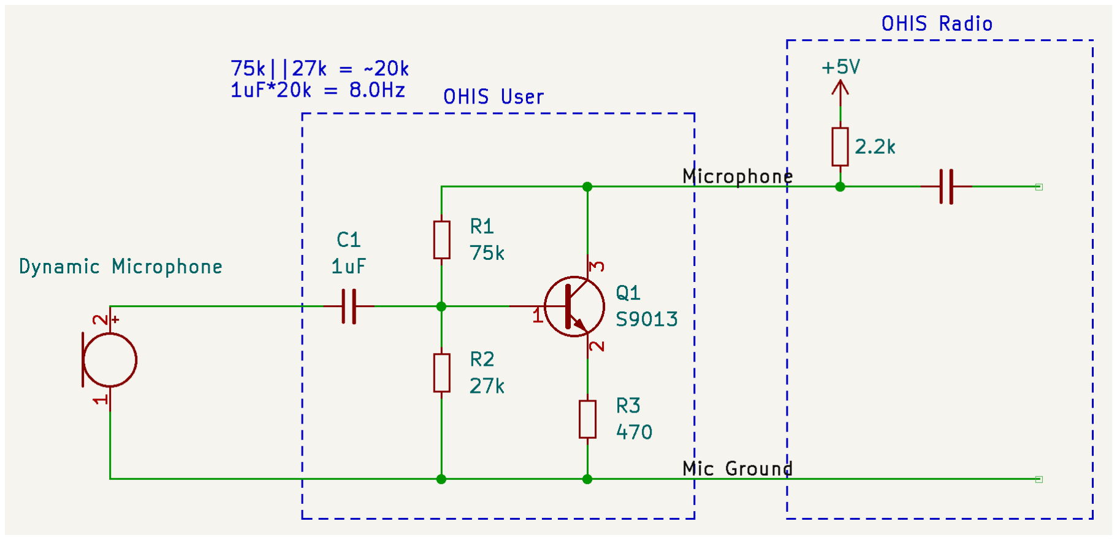
[picture p90: figure]

Video

# Dynamic Mic Pre-Amp

Part of the open standard, freely available for use.

Video

Technical Details...

See the QR codes at the end of this presentation for the Standard Document, the Groups.io email list, and GitHub repository.

Video

# When is OHIS useful?

Video

# When is OHIS useful?

- When you have several different radios and headsets.

Video

# When is OHIS useful?

- When you have several different radios and headsets.
- When you operate in a shared environment and users have their own (different) headsets.

Video

# When is OHIS useful?

- When you have several different radios and headsets.
- When you operate in a shared environment and users have their own (different) headsets.
- Examples: Field Day, club shack, or an Emergency Operations Center.

Video

# When is OHIS useful?

- When you have several different radios and headsets.
- When you operate in a shared environment and users have their own (different) headsets.
- Examples: Field Day, club shack, or an Emergency Operations Center.
- When you want to design and sell a device that goes between the User and the Radio, and have it work everywhere without overly complex input and output interfacing.

Video

# When is OHIS useful?

- When you have several different radios and headsets.
- When you operate in a shared environment and users have their own (different) headsets.
- Examples: Field Day, club shack, or an Emergency Operations Center.
- When you want to design and sell a device that goes between the User and the Radio, and have it work everywhere without overly complex input and output
interfacing. | ahem

Video

# When is OHIS over-kill?

Video

# When is OHIS over-kill?

- When you only have one radio, or one headset, or any situation where the “full mesh” problem doesn’t apply.

Video

# When is OHIS over-kill?

- When you only have one radio, or one headset, or any situation where the “full mesh” problem doesn’t apply.
- When you already have all the adapters you need.

Video

# When is OHIS over-kill?

- When you only have one radio, or one headset, or any situation where the “full mesh” problem doesn’t apply.
- When you already have all the adapters you need.
- When you prefer the simplicity of a single adapter between you and your radio.

Video

# Why an Open Standard?

Video

# Why an Open Standard?

- Open is how we get out of this mess.

Video

# Why an Open Standard?

- Open is how we get out of this mess.
- Halibut Electronics needed to solve this problem for future products, and I am not Gillette.

Video

# Why an Open Standard?

- Open is how we get out of this mess.
- Halibut Electronics needed to solve this problem for future products, and I am not Gillette.
- This is a good DIY project, and I love DIY projects

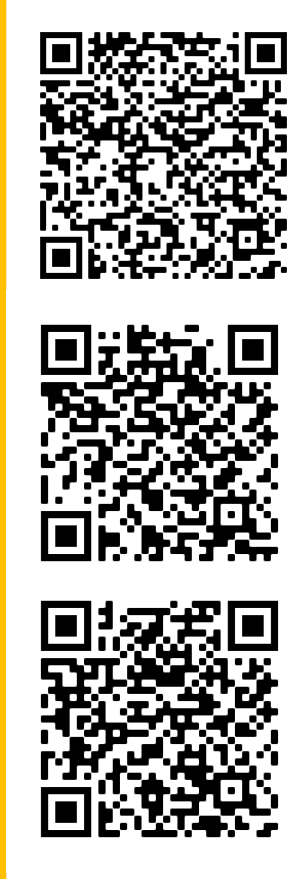
[picture p91: figure]

Video

# Learn more

Groups.io mailing list:

https://halibut-electronics.groups.io/open-headset-interconnect-standard/

GitHub repository:

https://github.com/Halibut-Electronics/Open-Headset-Interconnect-Standard

The Standard document:

https://halibut-electronics.github.io/Open-Headset-Interconnect-Standard/Open-Headset-Interc onnect-Standard.pdf (https://halibut-electronics.github.io/Open-Headset-Interconnect-Standard/Open-Headset-Interconnect-Standard.pdf)

# Questions and Answers

# Beginning now

Video

# Slide Title

Slide Content
