open-headset-interconnect-standard/ohis/Images/OHIS Overview - Radio Highlighted.png

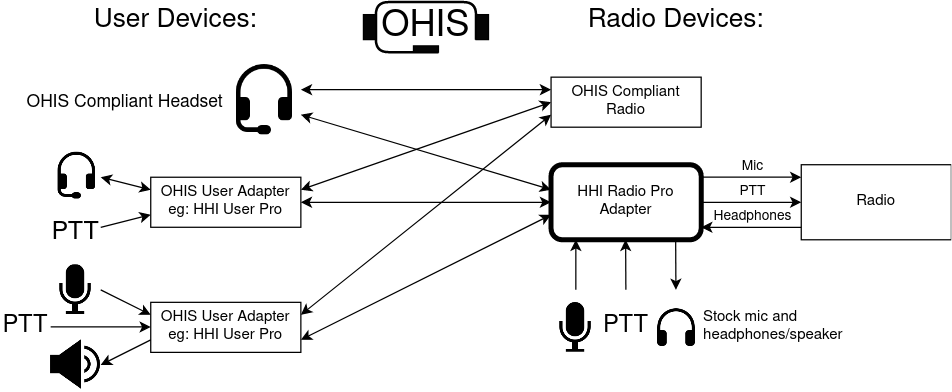
Images/OHIS Overview - Radio Highlighted.png
