open-headset-interconnect-standard/ohis/Images/User Adapter-Dynamic Mic Element-2381x1057.png

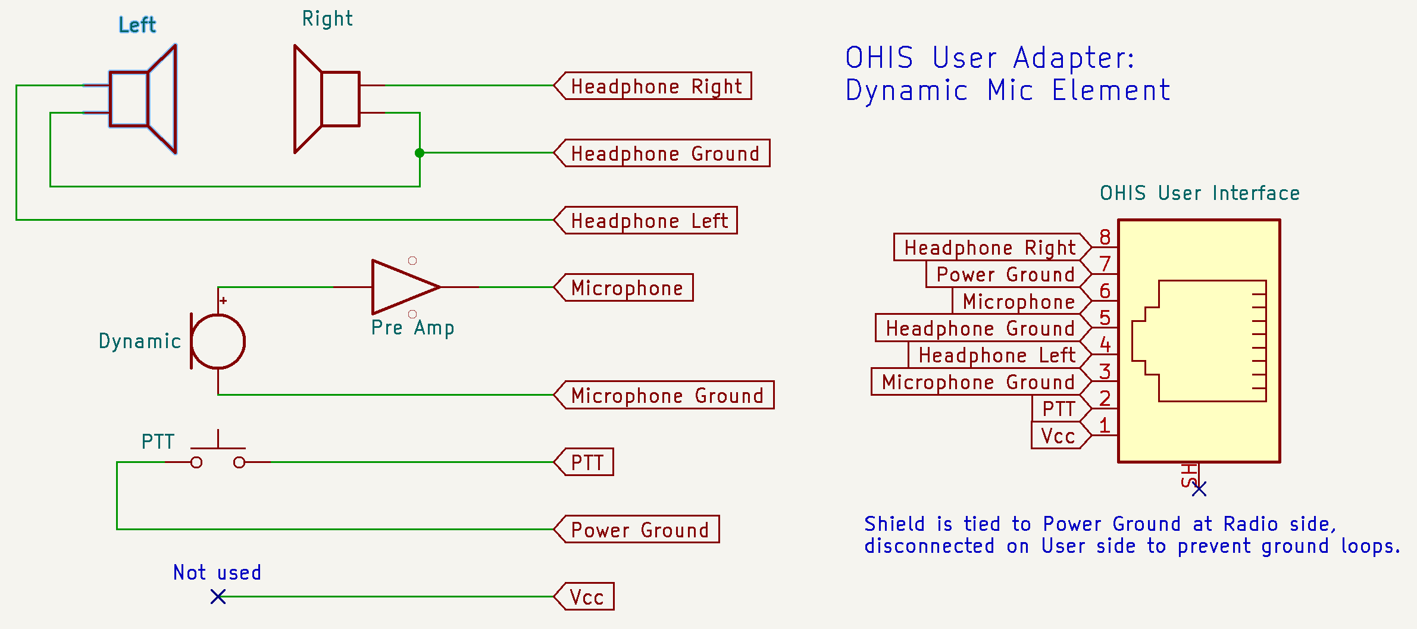
Images/User Adapter-Dynamic Mic Element-2381x1057.png
