open-headset-interconnect-standard/ohis/OHIS Presentation/QR GitHub.png

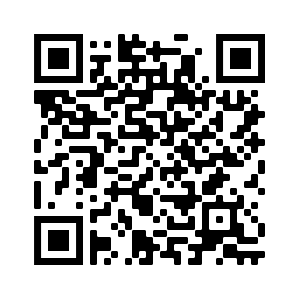
OHIS Presentation/QR GitHub.png
