open-headset-interconnect-standard/ohis/OHIS Presentation/QR GroupsIO.png

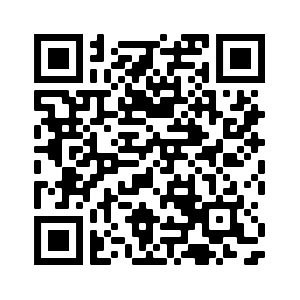
OHIS Presentation/QR GroupsIO.png
