open-headset-interconnect-standard/ohis/OHIS Presentation/QR OHIS Document.png

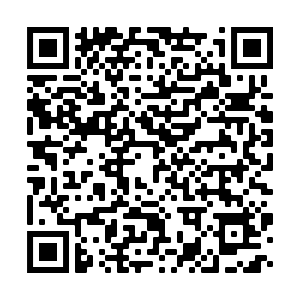
OHIS Presentation/QR OHIS Document.png
