open-headset-interconnect-standard/ohis/Wiring/RadioSport to OHIS Cable.ods

Signal | RadioSport 6-pin miniXLR | OHIS RJ-45
Mic - | 1, White | 3
PTT | 2, Yellow | 2
Mic + | 3, Red | 6
Left Speaker | 4, Green | 4
Right Speaker | 5, Black | 8
Ground | 6, Blue | 5, 7 | (OHIS allows for separate headphone and power grounds)
+5vDC | not connected | 1
Shield | Shield | Shield
