open-headset-interconnect-standard/ohis/(threads)

Thread 1 (2022-07-11):

Write OHIS document

SmittyHalibut, 2022-07-11:
* tl,dr: quick technical description of interface standard
* Definition of problem we're addressing.
* Detailed explanation of each part of the standard
  * Physical: RJ-45, shielded if possible. User and Radio sides.
  * Mic: how to convert from type to type, preserving balance when possible, etc.
  * Headphones: address mono vs stereo
  * Power: range of acceptable power, preferred power, labeling requirements.
  * PTT
* Acceptable compromises:
  * Combining grounds
  * Source of power
* Contacting us and Contributing to the standard.

SmittyHalibut, 2022-10-04:
Early WIP version is published.  I'm working on getting reviews done, from volunteers, and from a paid tech writer.

SmittyHalibut, 2022-10-04:
Sections to add:
* Define the OHIS logo.  Make it required on OHIS ports, and not-allowed on non-OHIS ports, to remove confusion on where things can be connected.

SmittyHalibut, 2022-11-22:
Moving remaining work to individual tickets.
https://github.com/Halibut-Electronics/Open-Headset-Interconnect-Standard/issues/5
and more as they come up.

Closed 2022-11-22.

Thread 3 (2022-07-11):

Design Mic pre-amp

SmittyHalibut, 2022-07-11:
Design a mic pre-amp to connect a dynamic mic to device expecting an electret.

I think this can be done using the bias power on the electret mic feed:

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

R2 and C2 are part of the device consuming the Electret mic.  The node between R2, C2, R1, and T1 is the "mic" pin on HIS, and ground is "mic return".  This only requires C1, R1, and T1 to turn a dynamic mic into an electret level signal.

...we just need to, ya know, pick R1 and T1.  (C1 is likely to be a 1uF ceramic.)

HIS will specify standards, but will also allow direct connection to a radio that's already expecting an elecret element.  So R2 and the voltage are likely to be all over the place.

SmittyHalibut, 2022-08-24:
http://halibut.com/~mark/2022-08-18%20First%20Test%20Of%205%20Component%20Preamp.mp3

The pre-amp design works really well!  I've got several test boards on their way to me, and will be sending them off to users to test on their setups.  But this sounds remarkably good.

SmittyHalibut, 2022-10-04:
Mic Preamp boards sent to users (identities not posted here, so I don't DOX them if this repo ever becomes public.)  Waiting on responses.

SmittyHalibut, 2022-12-14:
Responses from Mic preamps have been good, with one case of noise that is likely caused by unshielded cables.

SmittyHalibut, 2022-12-14:
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

That's from https://www.epanorama.net/circuits/dynamic_to_electretinput.html

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

And that's from https://hf5l.pl/en/electret-microphone-instead-of-dynamic-and-vice-versa/

Both are showing similar circuits, and similar to what I've already designed above.  I need to compare component values and see how close they really are.

SmittyHalibut, 2022-12-14:
Also note https://github.com/Halibut-Electronics/Open-Headset-Interconnect-Standard/issues/6 talks about varying voltages and series resistances when driving an electret.  My original assumption about 5v and 2.2k ohms was incorrect.  So make sure the amp _I_ designed works with varying source voltages and series resistances.

The goal of the relationship between source voltage and series resistance is to drive a given bias current (0.5mA) through the electret element, and therefore through our amp circuit.  So I THINK it'll work out ok.  But I need to do the math to verify.

SmittyHalibut, 2023-02-03:
When testing Radio Pro v1.1b in https://github.com/Halibut-Electronics/HHI-Radio-Pro/issues/19 I have been using as many mics and headsets as I can, and my Heil dynamic mic is NOT working with the mic pre-amp design I have. No audio.

I reconfigured one pre-amp as the second design in https://github.com/Halibut-Electronics/Open-Headset-Interconnect-Standard/issues/3#issuecomment-1352023799 (470k R_cb, and 100R R_e, using the 6.2k current limiting resistor in the DC bias circuit as the 5.1k R_c).  If I yell, I get a bit of heavily distorted audio.  Something isn't right there.

I think I need to simulate this circuit.  *sigh*  One of these days, I'll figure out Qucs.  Maybe this is that day?

SmittyHalibut, 2023-02-07:
I simulated the Guitar Circuits amp, and the hf5l.pl amp.  Guitar Circuits got us about 15dB gain, and the hf5l got about 27dB.  With a 5v/6.2k power source, neither was heavily distorting, though I haven't figured out how to measure THD with Qucs yet.

SmittyHalibut, 2023-02-20:
I'm not sure why the mic amps aren't working as expected.  I've started experimenting with OpAmp based mic amps: https://github.com/Halibut-Electronics/HHI-User-Pro/issues/10

But, this passive component amp really should work, and it did work with test boards.  But it doesn't seem to be working with the Heil headset.

SmittyHalibut, 2023-03-08:
'CUZ I'M A DUMBASS.  When using your Heil to test Dynamic mics, make sure you have a Dynamic mic element loaded into the headset, not the iC element, meant for Icoms, which is an Electret.

Swapped the mic element, works a champ.  *sigh*  At least I learned a fair bit about circuit modeling, which is a skill I'll definitely be able to use going forward.

Also tested my PR-781 using an XLR to 3.5mm cable.  Also works great.

While working on https://github.com/Halibut-Electronics/Open-Headset-Interconnect-Standard/issues/6 I also designed an attenuator that works across both an Electret element, and the output of this dynamic mic amp.

I've moved the "Update the mic preamp design in the standards document" to https://github.com/Halibut-Electronics/Open-Headset-Interconnect-Standard/issues/10

Resolving.

Closed 2023-03-08.

Thread 6 (2022-11-29):

Research proper Electret mic driving requirements

SmittyHalibut, 2022-11-29:
5vDC Bias through 2.2k is _WAY TOO HOT_ for every radio I've used it on.  Below is an example of what I measured by another radio.

With the FHM-3 hand-mic plugged in, the Flex 6400 has 1.8vDC at the Mic connector port.

Internally, the Mic+ goes through R1, a 2k series resistor, then branches two directions:
1. Mic:  The electret mic element, and a small chip capacitor (unknown value, but probably very small), are in parallel to the Mic- pin.
2. Power filter: A .33uF electrolytic capo, and R2, another 2k resistor, in parallel, to Ground.  (separate from Mic-).

The DC voltage across R1 is 1.10v (0.55mA), and the DC voltage across R2 is 0.70v (0.35mA).  This means there's .20mA across the sum of leakage current on the caps, and through the electret mic element.

I don't know what the internal-to-the-Flex resistance and supply voltage are, but given the 0.55mA total current measured above, these are the common combinations that would work:
* 1k, 2.3v
* 2k, 2.9v
* 3.33k, 3.3v
* 5v would be 5.818k

Wait a sec, the "way too hot" here is the headset mic going straight into the Flex.  This isn't my Electret driving circuit.  I'm still filing this ticket to document the above stuff about the FHM-3.

SmittyHalibut, 2022-11-30:
Oh, look at this:

https://edge.flexradio.com/www/uploads/20200818185014/FLEX-6400M-and-FLEX-6600M-User-Guide-v3.x.pdf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

aka: https://www.flexradio.com/documentation/flex-6400m-and-flex-6600m-user-guide-pdf/ Page 32

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

Looks like it's a 3.0v and 2.1k. Which matches my measurements above, pretty closely at least.  3-1.8v = 1.2v/.00055A = 2.181k.  Close enough for me.

SmittyHalibut, 2022-11-30:
http://mynixworld.info/2017/09/01/simple-electret-microphone-circuit/

Looks like the goal is: 2v across the Electret, .5mA through it.  R = (V_cc-2v)/0.55mA

SmittyHalibut, 2022-12-01:
2v across the Electret, .5mA through it, gives:
* 5vDC: 6k
* 3.3vDC: 2.6k

## TODO
* Update the OHIS document accordingly.

SmittyHalibut, 2022-12-14:
Putting these notes here for lack of a better place to put them:

http://www.uneeda-audio.com/pads/

Shows how to pad an electret down to dynamic level.  Specifically:
* Output impedance of the pad needs to be low, 100R or so.  Expect a load impedance of 600 to 1.5k ohm.
* That means that the shunt resistor needs to be that impedance.  Then the series resistor is selected for the appropriate dB loss.
* Because I like operating in powers of 10 when I can, and I don't need it to be EXACTLY 20dB...  I'm going to 100R and 1k for my attenuator resistors.

SmittyHalibut, 2023-02-04:
That didn't work.  The 100R shunt across the output just loaded something too much and the output was low and distorted.  I think we need to trim first, then buffer (again).

SmittyHalibut, 2023-03-02:
OR, and here me out here, a 100R shunt resistor on an electret circuit just pulls too much DC.  If I put a DC blocking cap in series with it, it'll not pull the DC too low, but will still attenuate the AC.

Problem is, 100R needs 100uF to pass 16Hz.  This is effectively a high pass filter, because whatever we don't shunt will get less attenuation and appear louder at the mic input to the radio. So if this shunt cap is too small, we'll be sending too much rumble to the input. So we have to be careful here.

SmittyHalibut, 2023-03-03:
Testing shows a 47uF electrolytic cap in series with a 1k trim pot configured as an adjustable resistor, across the OHIS Mic+ and MicGnd, will attenuate a signal, of both the electret mic element I tried (CTIA headset), and the 5 component dynamic mic amp (with Heil Pro 7 mic element).  The cap blocks DC and only attenuates audio.  The adjustable resistance creates a voltage divider with the source impedance of the electret mic/mic amp output.

So, the simple case of an adjustable User device is the bypassable mic amp, with the 47uF/1k pot across the output.  I think I like this design.

SmittyHalibut, 2023-03-08:
Ok.  Summary of what we have here:
* DC Bias Voltage with series resistance applied to drive about .5mA through a 2V drop.  eg:
  * 5vDC: 6k
  * 3.3vDC: 2.6k
* Expected output:
  * Thankfully and coincidentally, mic sensitivity is measured at about comfortable speaking voice level. So the sensitivity rating (units usually something like "dBV at 1Pa at 1kHz") is about what you can expect to see from the microphone when used like we are using it.
  * RMS, About -42dBV (8mV) to -48dBV (4mV).
  * Peak voltages, between 11.3mV and 5.6mV.  (Peak voltage becomes important when designing a VU meter.)
* Some electrets are hotter than this.  An attenuator can be added across the Mic+ and Mic-/MicGnd lines.  A 47uF (or greater) capacitor, in series with a 1k adjustable resistor (or pot with wiper tied to the clockwise end).  The capacitor prevents DC from passing through the attenuator.  The cut-off frequency is 1/2*Pi*RC.  R is the 1k pot, possibly turned down to ~100R or lower.  C is the 47uF.  100R*47uF = 34Hz high pass. 10R*47uF = 338Hz.

Works with dynamic mic preamp, as documented here: https://github.com/Halibut-Electronics/Open-Headset-Interconnect-Standard/issues/3

From a standards point of view, I think the critical numbers are the -42dBV to -48dBV, and the resultant 11.3mV and 5.6mV peak values.  In addition to the Mic Preamp in https://github.com/Halibut-Electronics/Open-Headset-Interconnect-Standard/issues/3, the standard should include a VU meter design:
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

Specifically, the voltage divider ladder values.
* Use a 1.2v regulator or voltage reference to define the top of your voltage divider ladder RELATIVE TO THE AUDIO REFERENCE POINT!  Note that the "Gnd" pin on U2 is tied to Bias, so it's 1.2vDC above the audio center, NOT above 0v or Vdd.
* Three resistors: 5.1k, 4.7k, 91k
* The junctions between those values produce: 0.0607v and 0.117v, just about right for the -42dBV to -48dBV range (see below).
* Note these are 10x expected AC peak values!  Notice that the precision rectifier on the left side also has 10x gain (100k input, 1M feedback).  This just makes the voltage divider values larger, easier to get precision from a 1.2v reference.
* Peak hold time on the VU meter is defined by the RC of C7 and R16.  These values (1M and 1uF) are pretty good (qualitative, I know...)

Ok.  I think that's the summary of everything I've learned about Electrets.  This will need to get put in the OHIS standard doc.  See https://github.com/Halibut-Electronics/Open-Headset-Interconnect-Standard/issues/10

Resolving.

Closed 2023-03-08.

Thread 7 (2022-12-02):

Add alternative physical standards

SmittyHalibut, 2022-12-02:
Discussion has brought up that RJ-45 isn't a very rugged connector.  Several alternatives have been proposed:

(To be clear: these are proposed as **additional** alternative standards, not to replace RJ-45.  RJ-45 will remain the "default.")

## EtherCON
https://www.neutrik.com/en/products/data/ethercon

Basically, an RJ-45 in an XLR shell.  I like this for its backward compatibility.  The only thing required in the standard is to mention that RJ-45 sockets could use EtherCON connectors instead, which would allow the user to choose EtherCON cables for ruggedized installs.

## DE-9
https://en.wikipedia.org/wiki/D-subminiature

They're ubiquitous, inexpensive, very rugged, and people know how to use them.

My concern with DE-9 is that there's no existing standard for paired pins.  So it would have to be a shielded cable, or risk picking up noise in the mic line.  Even with a fully shielded cable, there's the risk of cross talk between headphones and mic.

Add to the document the following:
* Pinouts: Make sure that paired signals are close to each other in the connector; a 1-to-1 mapping with RJ-45 pinout would have Mic+ and Mic GND split across the connector, and that's bad.
* Male/Female conventions: At first blush, the Radio side should be female and the User side male.  Because the Radio side provides 5vDC power; if it were male, it would risk accidental shorting of those pins.
* Cables must be either paired, or shielded, or ideally both.

## miniXLR 6-pin
http://www.arlancommunications.com/products/amateurRadio/radioSport/Headsets.asp
https://www.switchcraft.com/mini-xlr-connectors/?pg=1&mpp=96&n4=6

Chatting with David Bottom of Radio Sport, he STRONGLY encouraged use of the 6-pin miniXLR.  It's an existing standard on headsets, is commonly available, and is very rugged.  He's had very good experience with them.

The problem is they're only 6-pin:
1. Mic GND
2. PTT
3. Mic+
4. Left Speaker
5. Right Speaker
6. Speaker Common/PTT Gnd
7. Cable Shield to connector shield.  (Separate from Ground)

It combines Headphone GND and Power GND (which isn't the end of the world; at least it keeps Mic GND separate), and it does not provide any power pin.

Add to the document:
* Pinout: For the love of bacon and all that is tasty, use the existing pinout listed above.
* Male/Female convention, though I think this is pretty solidified: Cables are Female to Female, devices are Male.
* Cables must be paired, or shielded, or both.

## miniXLR 8-pin
https://www.switchcraft.com/mini-xlr-connectors/?pg=1&mpp=96&n4=8

An 8-pin miniXLR loses compatibility with the existing 6-pin standard, but allows us to remain electrically consistent with the RJ-45 "base" standard, and get all the other mechanical benefits of the miniXLR connector.

Add to the document:
* Pinout: Probably start with the 6 pin and just add what we need.
* Male/Female conventions. Same as 6 pin
* Cables bla bla, same as 6 pin.

SmittyHalibut, 2023-11-21:
Suggestion from ... I can't remember where, but look for something that can be made waterproof for HT use.  I think they mean water proof while not being used.

I'm sure there are ways to water proof an RJ45, but I think they were also looking for something smaller/thinner.

Thread 8 (2022-12-15):

Can standard contain alternative CW pin diagram

hcarter333, 2022-12-15:
Not so much an issue as a proposal. Could the standard also include a pinout for a CW keyer rather than a mic? Folks might like, (I suspect very much), to bring their own keyer as well.

I've built up a prototype of this idea at https://github.com/hcarter333/rockmite/issues/6

Thanks very much for putting together the standard! It inspired the work I did above. Also, if this isn't appropriate place for this question/suggestoin, please let me know, and I'll close or delete the issue. Thanks again!
73 de KD0FNR

SmittyHalibut, 2022-12-15:
I literally just responded to your email to the OHIS mailing list and came here to enter an Issue in the backlog.  You beat me to it.  :-)

This is absolutely an appropriate place for this.  Thank you for submitting your idea.  It's a great one.

Unfortunately, the pinouts you listed above are not OHIS compliant.  OHIS is the definition of the signals, and what pins they go on.  Repurposing the Mic+ and Mic GND pins for contact closures breaks OHIS compatibility.

Instead, I propose the PTT line be extended from "Contact closure to ground for PTT" to a more complex analog signal:
* 1.00 * V_cc: Idle.
  * This is the "pulled up" state, same as before.
* 0.75 * V_cc: Button 3, Dit, Up
* 0.50 * V_cc: Button 2, Function
* 0.25 * V_cc: Button 1, Dah, Down
* 0.00 * V_cc (aka GND): PTT.
  * This is the "contact closed to ground" state, same as before.

This should probably be an optional extension that not every device has to support. eg: some radios that don't have or use extra buttons like a keyer, won't bother implementing these.

Encoding this would be pretty easy, just a voltage divider, so long as the pull-up impedance is known, or higher than the voltage dividers.

Decoding is more tricky.  Probably a pair of LM393 comparators, a voltage divider ladder, and some logic gates on the output to select only one output at a time.  Unless someone knows a better way to do this.

If I help with the circuits for this, would you be willing to prototype and test this @hcarter333 ?

hcarter333, 2022-12-18:
@SmittyHalibut I'd be will to prototype. The circuits as described above seem straightforward enough. Cool!

SmittyHalibut, 2023-02-27:
Updating summary to reflect how I'm thinking about this now.

SmittyHalibut, 2024-02-06:
This came up on the OHIS mailing list again: https://groups.io/g/ohis/topic/classic_radio_integration/102146840

Rather than define it by voltages as in https://groups.io/g/ohis/topic/classic_radio_integration/102146840, I think I like defining it by impedance instead.  Something like:
* Hi-Z is idle.
* 0R to ground is PTT.  (These two make it backward compatible with the current design.)
* 10k to ground is Dit.
* 33k to ground is Dah.
* 7.7k to ground is Dit and Dah together (spoiler: 10k||33k=7.7k)

Thread 9 (2022-12-29):

Research: Audio taper trim pots

SmittyHalibut, 2022-12-29:
A common problem that all OHIS manufacturers will run into is the lack of availability of audio taper trim pots, for use when matching levels between OHIS and devices.

[AI8W suggests](https://mastodon.hams.social/@AI8W/109597293371252559) putting a fixed resistor in parallel with a linear pot to get a somewhat-not-really logarithmic taper.  I'll research that and see what it does.  (Easy to simulate, but I suspect someone already has done that.)

The other idea I came up with is to split the 10/90% audio taper into two separate pots stacked on top of each other, one 1/10 the resistance ("fine") of the other ("coarse").  Take the output from the sweep of the Coarse pot, and tie the sweep of the Fine pot to the midpoint between the two pots.  For adjustment, turn the Fine pot all the way up, and use the Coarse adjustment to find your volume.  If with the coarse all the way down it's still too loud, then start adjusting the fine.

SmittyHalibut, 2022-12-29:
## Source:
http://www.geofex.com/article_folders/potsecrets/potscret.htm is a good page talking about this.

## Qucs simulations
I also did some Qucs simulations:
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

Source impedance is 10R.  Pot is 1k (split into R2 and R3, with equations doing the heavy lifting.)  The taper resistor is 1/10 of the pot (100R) for a large change in slope.  The load impedance is 100k.

The source and load impedances are 100x outside of the pot (source = 1k/100 = 10R, load = 1k*100 = 100k), to minimize the impact of the variable impedance the tapered pot will represent.

Having said that, I also tested with a 10k and 1k load resistance, and the graph barely changed.  This makes sense since the load is in parallel with R_taper; as long as R_load is 10x R_taper (or, 1k in this case), it will be dominated by R_taper and not make much effect on the whole graph.  Meaning, our load impedance can be a wide range, so long as it's ~10x R_taper or more.

### Qucs Result: Output voltage as a function of sweep
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
Blue line is the resultant voltage, graphed linearly.  The red line is the same, graphed logarithmicly.  A perfect log pot would result in a straight red line, so curvature in the red line shows how not-logarithmic the graph is.

So, this isn't a great logarithm, but it's WAY better than a linear pot.  Notably, it gives a lot of precision at the low end, which is what I really want.

### Qucs Result: Input impedance presented to the source, function of sweep
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
This shows the impedance of this pot as presented to the source.  Note that it varies by >90%, from 1k down to below 100R.  This is why this architecture isn't normally used.

But, as long as your source can handle driving the minimum presented impedance, then it should be ok.

## Analysis
I like the simplicity of a single pot.

### Microphone trimmer
The source on the Mic trimmer is our own opamp, so we know the source impedance is very low, plenty low to drive the pot.

The load is the microphone input to the radio, which is likely to be at LEAST 600R, more likely 1k or 10k.  I graphed a 600R load and it's still pretty darn good.

So, I'm calling this good.

### Headphone/Speaker trimmer
I don't get to specify the source on this one.  The source is likely to be:
* Line: 600R
* Headphone: 16R or less
* Speaker: 8R or less

So the worst cast to consider is Line output, 600R.  Unfortunately, even with the volume turned all the way up, this results in a voltage divider between source impedance (600R) and R_taper (100R), which results in a 1/6 decrease in voltage, even at full blast.

However, I specify the load here, our headphone amp, which is 10k.  So I can go to a 10k pot/1k R_taper safely.  That makes the voltage divider 600/1000, or a little less than half voltage.

Going to 100k/10k makes R_taper and R_load equal, effectively dropping R_taper by half.  This results in a much flatter graph (not a bad thing), and a full volume much closer to 100%:
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

## Conclusion
* Mic Trim: 1k pot, 100R taper resistor.
* Headphone Trim: 100k pot, 10k taper resistor.

SmittyHalibut, 2022-12-29:
## Lessons learned:
* The load impedance doesn't matter TOO much. It's primary impact will be to change the value of R_taper, since it's in parallel with R_taper, and the impact that has on the graph.
* The source impedance DOES matter, A LOT.  It impacts the maximum output volume, by defining a series voltage divider with R_taper.  So as long as R_taper >> R_source, it'll be ok.  10x seems a good definition of >> here.
  * The impedance presented to the source varies between R_pot (all the way down) and R_pot in parallel with R_taper (all the way up).  Above, I talk about the worst case of this being R_taper.  But if there are any frequency dependent parts of the output of the source (eg: an RC DC block), this needs to be considered.
* The ratio between R_pot (larger) and R_taper (smaller) will affect the curve.  Larger ratio, the "more log like" the resultant taper will be.  But it also results in a steeper curve at the low end. The web page listed at the top of this ticket graphs values up to 6x.  I've gone with 10x.  Somewhere in that range seems reasonable.

But, as long as the above is considered, I think this works well to make "an audio taper trim pot."

Closed 2022-12-29.

Thread 12 (2023-09-04):

Feedback from W6EL

SmittyHalibut, 2023-09-04:
Got a very good email from Elliott L, W6EL, who makes the following points (I'm paraphrasing since I don't have permission to paste his actual email publicly.)

## 1: Extend the standard to include GX16, same pin out as 8p8c
His concern is having an actual coaxial shielded mic line inside the bundle of other signals (specifically headphones), not just having a single shield over the whole bundle which would allow cross-talk between the headphones and mic lines.  And building such a cable in a Modular connector is pretty much impossible (I agree with that.)

However, I strongly disagree that GX16 is the correct connector to use.  I don't want to make YET ANOTHER INCOMPATIBLE use of that connector.  Also, GX16 connectors are a royal PITA to acquire for use on PCBs (as me how I know).

Instead, OHIS already specifies the DE-9 as a Rugged connector option.  I believe it addresses his expressed concerns (easy to solder coax to, easy to make custom cables) and addresses my concerns as well (not already a standard in audio, commonly available, still rugged (GX16 is as well)).

I've responded to Elliott with my counter argument and am seeing whether he has any further concerns, or a rebuttal.

## 2: Vcc spec should include noise tolerance.
He's absolutely right.  Specify a ripple limit, and frequency.

## 3: Headset Level is vague
His concern is that different radios will have different level outputs, and that should be standardized.

I understand his point, and maybe the standard should be more clear on what "headphone level" is.  It's currently specified as 0dBV into 16R load.  Is this "correct?"  Is there a better way to specify this?  This is a low-impedance spec; what about high impedance cans that might require more voltage, but less current?  What THD?

It's also not clear that that's for max volume.  The ACTUAL listening volume is adjusted by the Radio device, not by the User device.

## 4: PTT voltage and current spec
He's absolutely right.  Specify max pull-up voltage, min sink current capability, and max forward voltage drop.  Make sure that specification works with BJTs, FETs, Optoisolators, contact switches, and relays.

Thread 14 (2023-09-19):

Design Open Source User Adapter

SmittyHalibut, 2023-09-19:
Design a simple schematic and board layout for a generic User adapter that can be configured by the user for various different headsets.

Keep it simple, make it a good DIY project.

CC-BY, credit to OHIS.  But allow commercial use and extension (read: not -NC and not -SA)

SmittyHalibut, 2023-10-04:
## Left to do:
* Finish up any more artwork on the main board?
  * CC-BY graphic?
  * Label the existing QR code
  * Add a version number tag to the board.
* Layout a top board
  * With hole for PTT button
  * Possibly with cut-out for RJ-45, if stand-offs are short enough.
* Layout an SMT version, or maybe add SMT outlines to the same board.
* Fill in BOM with Digikey/Mouser links, and LCSC links for the SMT options.

SmittyHalibut, 2023-10-06:
## Done:
* Ordered prototype boards.
* Ordered parts for 120 builds, to make 100 kits plus some prototypes for testing.
* The RJ-45 have tabs on the top that I didn't want exposed, so I went with a solid board on top, which requires 14mm spacers (13.4mm tall connector).  I exposed the copper, put a solid box on the solder mask layer, so the tabs on the RJ-45 would connect with the board on the top layer.  (It'll connect through the brass standoffs and screws too.)

## Vertical stack up:
From top to bottom:
* M3 6mm screw
* 1.6mm: Top board
* 14mm: Brass standoff
  * 4.4mm of top screw: 6mm - 1.6mm
  * 3.8mm of bottom screw: 10mm - 1.6mm - 3mm - 1.6mm
* 1.6mm: Main board
* 3mm: ABS standoff
* 1.6mm: Bottom board
* M3 10mm screw

Spacing between the boards is 14mm:
* [RJ-45](https://cdn.amphenol-cs.com/media/wysiwyg/files/drawing/rjhsex38x.pdf) is 13.46mm tall
* Pin headers with jumpers are <10mm tall (measured 9.2mm, rounding up for slack.)
* 3.5mm sockets are 5mm tall.
* [2N3904 (page 8)](https://www.mouser.com/datasheet/2/308/2N3904_D-2309276.pdf) is <10mm
* [Capacitors (pages 5 and 22)](https://product.tdk.com/system/files/dam/doc/product/capacitor/ceramic/lead-mlcc/catalog/leadmlcc_halogenfree_fg_en.pdf) are <6mm
* Resistors are very short.

Top surface of top board is 14+1.6mm = 15.6mm tall.  The PTT button is 15mm tall, and the cap makes it 1mm taller, so 16mm tall.  It will stick out through the top board by 0.4mm. Button travel is 0.25mm, so it will be MOSTLY flush with the top surface the whole time.

Just in case, I also just purchased some 16mm tall buttons to see whether they'll be a better choice.

SmittyHalibut, 2023-10-06:
Oh!  Also, check out https://open-headset-interconnect-standard.github.io/user-adapter/bom/ibom.html

Thread 15 (2023-12-29):

Microphone spec levels, generation, and calibration

gx1400, 2023-12-29:
The OHIS spec calls out

`The Microphone signal is a typical electret microphone signal: -45dBV +/- 3dbV into 600 to 1k
ohm`

Then goes on to describe the amplification needed for a dynamic mic

1. Should the spec section 3.3 be more clear about what an acceptable mic signal level is? Specifically " -48dBV to -42 dBV into a 1000 ohm resistive load"

I wonder if later in the spec you could outline the intent and methods for achieving those levels, for example the reference circuitry.

2. Are these dBV measurements measured as Peak voltage or RMS?

3. Do you have any feedback on how to reliably generate audio into the mic to verify those levels? Or would you ultimately expect the end user to verify audio levels with signal reports and adjusting mic gain settings?

I think I noticed a mic level adjust pot on the Halibut user adapter product. I was curious how a "OHIS compliant/calibrated mic setup might vary from user to user based on talking loudness and mic handling (distance from mic, etc)

5. Have you considered a recommended calibration procedure for a given mic and user adapter? I thought it would be cool to have a reference circuit that has a OHIS mic input, a bnc input for an signal/tone generator for calibration, maybe a fixed load and an oscilloscope output.

Then an end user could use a VU meter (even a few leds or an led bar segment, similar to an audio compressor meter) could help provide visual feedback that mic levels are appropriate for their hardware and talking style

gx1400, 2024-01-11:
1. User error on my side, but I do think there is some redundancy and conflicting information between section 3.3 and 5.3.  I think the spec is a little confusing in that 3.3 describes a 'typical' signal out into a load with a range of 600-1000 ohms.  I think Section 5.3 is again describing the impedance of the microphone element itself.  I wonder if your intent here was to provide contextual information, which is great but I think as a technical end user of a spec, it can muddy the "requirements" and lead to misinterpretation.

    ```
    3.3. Electrical Specification

    Microphone: The Microphone signal is a typical electret microphone signal: -45dBV +/- 3dbV into 600 to 1k
    ohm. The Radio device provides a DC bias voltage to power the microphone element, about 0.5mA across a
    2vDC microphone element (eg: 5vDC through 6.8k ohm resistor). Dynamic microphone elements require about
    10 to 15db of amplification, and for the DC bias to be blocked; this Standard provides a simple 5 component
    microphone pre-amp, powered by the DC bias, to bring a Dynamic microphone element up to Electret signal
    levels.
    ```

    I would suggest simplifying to:

    ```
    3.3 Electrical specification

    Microphone: The Microphone signal level shall be: -45dBV +/- 3dbV RMS into 600 ohm.

    This level is typical of electet microphones. See section 7.1 for notes on amplifying Dynamic element microphones.
    ```

    Or even better, I might suggest to nix Section 3.3 completely and allow for 5.3 to be the sole place you give actual numbers.  Having it in multiple places can be confusing in a technical document.
<br>
2. Thanks for the consideration!
<br>
3. Nix this comment.  Good feedback, entirely dependent on user and their setup.  Per the VU meter, I'll comment over on [#16](https://github.com/open-headset-interconnect-standard/ohis/issues/16)
<br>
4. Sorry auto formatting and retyping sections in markdown is messy, I believe I typed this on my phone.
<br>
5. No additional comments!

SmittyHalibut, 2024-01-11:
1. Finally back at my computer not my phone, I actually reviewed 3.3 and 5.3, and I agree with you.  I'll greatly simplify Section 3.3 (not just Microphone) to be just a very quick summary, and point to 5.3 for full details.  However, I will include the DC bias voltage in the summary, not just the signal level.  But I won't go into details, I'll just say that its needed.
4. I never pass up an opportunity to throw in a good Monty Python quote. :-)

Thread 16 (2024-01-10):

Design an Open Source in-line volume meter

SmittyHalibut, 2024-01-10:
The idea is that this device is a piece of test equipment, not needed for full time use.  A club could have one for everyone to use to help them adjust their mic levels.  Then, once adjusted, remove it from the circuit.

* Has two RJ45 sockets in parallel.  It's just a straight passthrough.
* Uses power from Vcc and Power ground.
* Has a VU meter on the Mic level, with fixed set points.
* Has VU meters on Left and Right headphones, with fixed set points.
* Include a power LED, maybe with a volt meter (which is basically a DC VU meter).
* Include a PTT LED.  Don't add an appreciable load to the PTT line, though.  So control a MOSFET, or a comparator, or something similarly high impedance input.  Don't just drive the LED off the PTT line directly.
* Bonus points: Test points to measure: Mic/MicGnd, HP:L/HP:G, HP:R/HP:G, Vcc/Power Gnd/PTT

gx1400, 2024-01-11:
Love this, thanks for the consideration.

I think VU meter for headphones would be unnecessary, since those are are going to be set by the end user with a volume knob regardless.

While having this in-line does provide power, I was envisioning this to be a stand-alone device to test the headset side of the exchange exclusively.  Including a 5.5 x 2.1 mm power jack would allow it to be standalone without touching a radio.

Suggest:

- mic is driven into a fixed resistive load (600 ohm? 1k ohm?) to set a consistent level.
- I like the power and PTT indicators.
- I could see the benefit of a cheap tone generator (even something as simple as an 555 timer with adjustable level just to verify headphones are wired correctly on the user adapter and functional).  Maybe two tones, one for left, one for right.  Bonus feature, add a pot to adjust the tone freq for left and right independent.
- thru-holes for an SMA or BNC connector for Mics, and HPs to simplify hooking up to a scope

SmittyHalibut, 2024-01-11:
Just for kicks and giggles, here's that board:
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

User adapter connects on the left, Radio adapter on the right.  Large pushbutton 8P2T switches next to both ports to select whether that port is connected to local test equipment, or through to the other port.  Then all the visibility stuff in the middle: VU meters, BNC taps, some switches to select what a given BNC is measuring, a local PTT, etc.

gx1400, 2024-01-11:
Opportunity for reducing real estate: use edge mounted SMA connectors.

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

I have about six other projects hanging that I need to close out before starting something new, but if you keep this ticket open, or open another issue for a standalone piece of headset test equipment.  I can try to start a KiCad circuit with some ideas to prototype in the future

SmittyHalibut, 2024-01-11:
RP-SMA!! Eww!  ;-)

Believe me, I know all about edge mount SMAs.  I literally have about 1000 in stock right now for various projects.  :-)

Since most o-scopes are BNC, I figured BNC was the right connector for this board.

As for you developing something, by all means!  Please do!  What's the whole-repo version of "I accept pull requests?" ;-)

Thread 18 (2024-03-06):

Handle custom schematic and board library entries.

SmittyHalibut, 2024-03-06:
There are several components that I had to draw myself, that aren't part of the KiCAD standard libraries.

Either:
1. Submit them to KiCAD so they become part of the standard library (where it makes sense to do so)
2. Generate an OHIS-specific library and publish it so that it can be easily added to anyone else's KiCAD install
3. Worst case, if it fits neither of those two, then include it in a library with the repo.

Thread 20 (2024-03-20):

Reference Vcc supply

SmittyHalibut, 2024-03-20:
A common input voltage is 13.8v +/- 15%. But OHIS uses 5v as its Vcc.

Using an LDO will dissipate up to 2W of heat. Not desirable.

Design a switching buck supply:
* as simple as possible, but no simpler.
* commonly available parts
* inexpensive
* efficient
* low noise (smp followed by LDO?)
* capable of at least 200mA. More would be better so it can be used locally inside the radio adapter too.
* open source, available for all to use.

Thread 21 (2024-03-30):

Clarify requirements around headphone levels

SmittyHalibut, 2024-03-30:
DrCampy: Hey, how are you doing?
I'm finalizing Module17.
I remember that we discussed how to implement OHIS on the board.
I also realize that the current implementation is a notable deviation from the standard, so I'm not sure that it is a good idea to keep it as-is...

Most notably, the audio output we provide is the one that normally goes to the speaker. So the amplitude is up to 5V. But your document says that it is expected to be between 0dBV (1V) and -10dBV (300 mV).

And if I want to stay close to 1V, I could repurpose one of the free operational amplifiers already on the board, but it is only able to provide a few mA (25 mA iirc) so it would not be able to power a load as low as 8 Ohms... . Also, it would be ground referenced but with a DC offset. If I want to cancel DC offset, I would need to put a DC-blocking cap but then, my low-pass cutoff frequency would be terrible if we must support up to 300 Ohms as stated in the standard

I need to know what you suggest for that. Also, maybe the standard needs to be more precise about what is acceptable (in terms of acceptable loads mostly).

Mark: Output: Just put a resistor in series, and that'll be fine.  I'm trying to figure out what value.  Probably something between 100R and 33R.  I know my stereo at home powers the headphones by just putting a 220R in series from the 100W speaker output!  If you do the math, it actually comes out pretty close.

DC blocking:  Yep, it's about 100uF or more.  And yes, it needs to be there.

I usually put 220uF or 470uF on stuff that I want to be full range.  For communications range, you can probably get away with 47uF (that's a guess, not actual calculation.)

And the low cut-off point goes DOWN (more bass) as your load impedance goes up.  It's not able to discharge the cap as quickly, so the cap is able to pass the lower frequencies better.

It's the 8 ohm side that you need to be worried about.

An 8 ohm load drawing through a 100uF cap has its -3dB point at 200Hz.  That's probably fine for this use case.

So, put a 100uF cap in series from the power amp, then two 33R resistors off the negative side of the cap toward the Left and Right channels on OHIS.  They'll serve dual purpose: Allowing one headphone to get shorted to ground without killing the other, and they'll brint a 5v (did you mean watt?) signal down to about right for headphones.

> put a 100uF cap in series...

No, it is indeed up to 5V signal (5V peak). Output power is 1W max

Thank you for the feedback, I ll crunch some numbers tomorrow and tell you what 😄

Also, I'm afraid that with serial resistors, I will have way more than 0dBV with higher impedance loads 😬

Mark: The good news is, high impedance loads can handle the voltage better and will actually need it.

DrCampy: Yes, but then maybe you should update the document with the standard to provide some guidance? And also include more details about the acceptable voltages wrt the impedances ?

*whew!* that's a lot of copy and paste.

mdiepart, 2024-04-21:
I'll just add a few explanations about where things become hard to follow:
The standard does not specify impedance requirements. It states that speaker impedances can be between 8 and 64 Ohms but also that it can sometimes be as high as 300 Ohms, without specifying an upper limit. However, the standard does specify that the full volume amplitude must be between 0 dBV and -10 dBV. Thus an implementation would have to keep this amplitude at all impedances.

What is needed is to specify a range of impedances for which the device must respect specific amplitude levels. With an added note that any impedance outside of those ranges might work but with no guarantee.

The last problem is that, if using a resistor to do a divider bridge, then the full volume amplitudes won't be respected. Indeed, if we take the numbers specified in the current version of the specifications, there is a ratio of >37 between 8 ohms and 300 ohms, but a ratio slightly above 3. Thus, it is very difficult to follow the standard if the implementation is using a divider bridge (the driving voltage would need to be very large with a very very large impedance before the OHIS connector.
