open-headset-interconnect-standard/ohis/Images/OHIS Overview.pdf

# OHIS

Example User Devices: | Example Radio Devices:

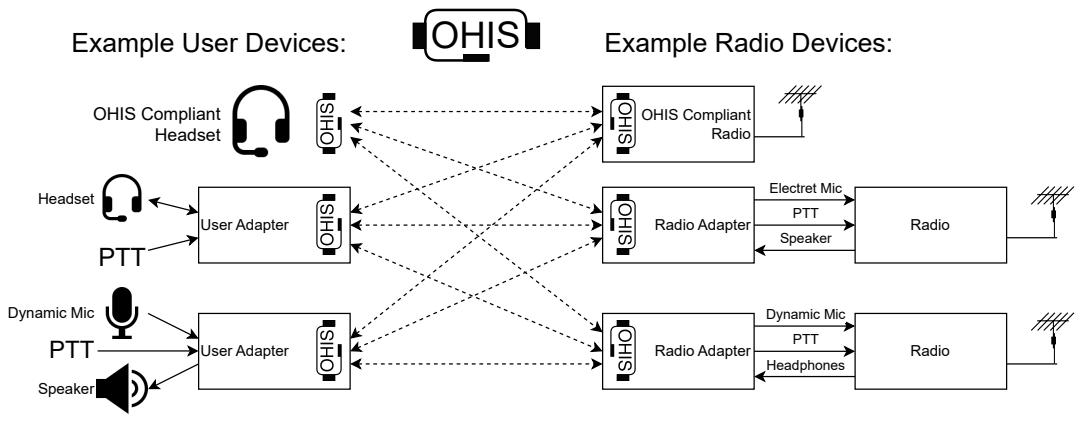
[picture p97: page 1]
Radio Adapter; Radio; Electret Mic; Speaker; PTT; User Adapter; OHIS Compliant Headset; OHIS Compliant Radio; Dynamic Mic; Headphones; Headset
