open-headset-interconnect-standard/ohis/Logo/OHIS Logo-Isolated.pdf

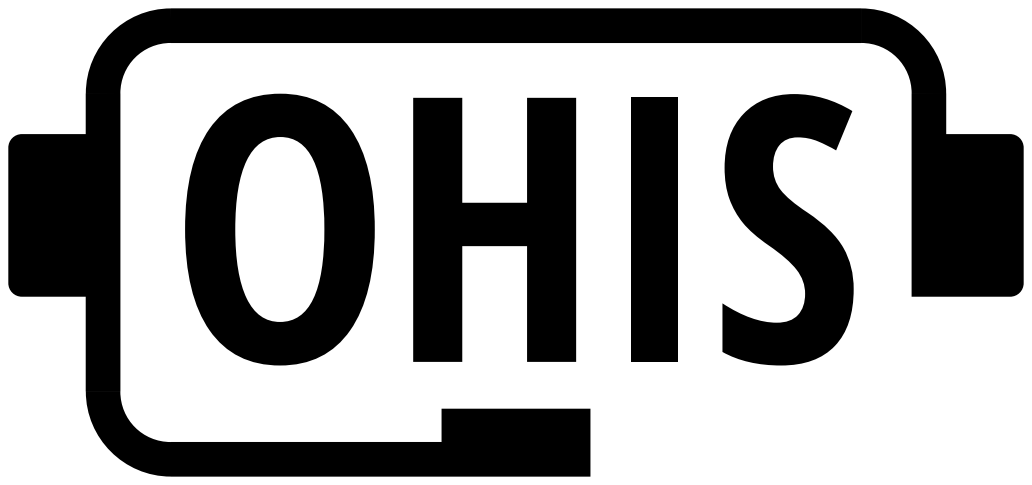
[picture p98: page 1]
