open-headset-interconnect-standard/ohis/Flyers/2023-05 Hamvention/OHIS Flyer - Back.pdf

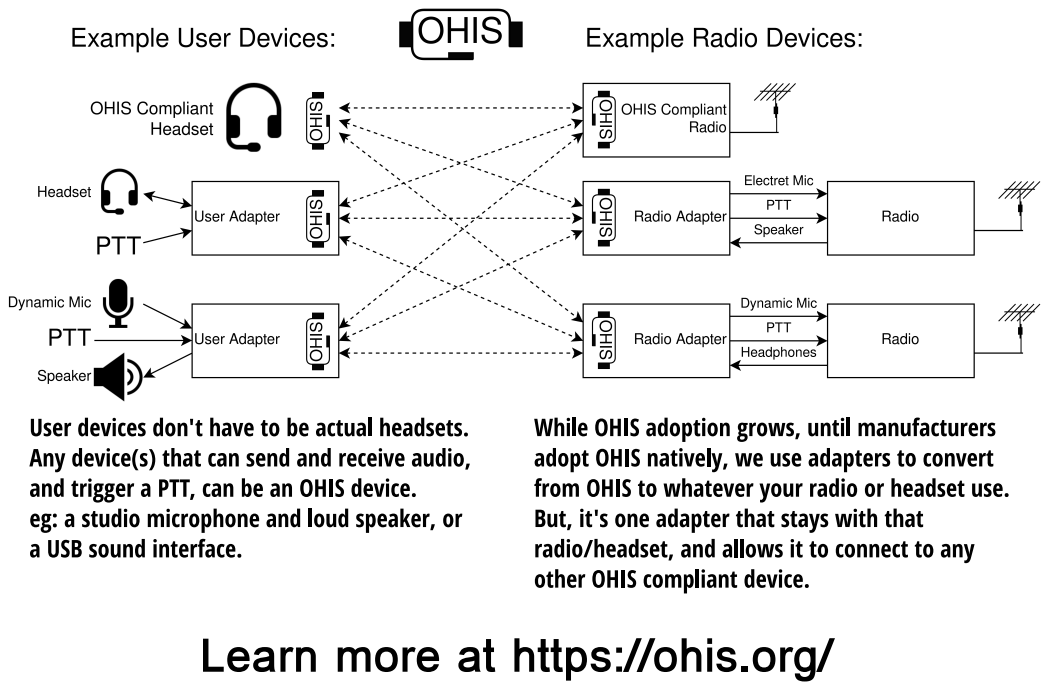
[picture p99: page 1]
