open-headset-interconnect-standard/ohis/Flyers/2023-05 Hamvention/OHIS Flyer - Front.pdf

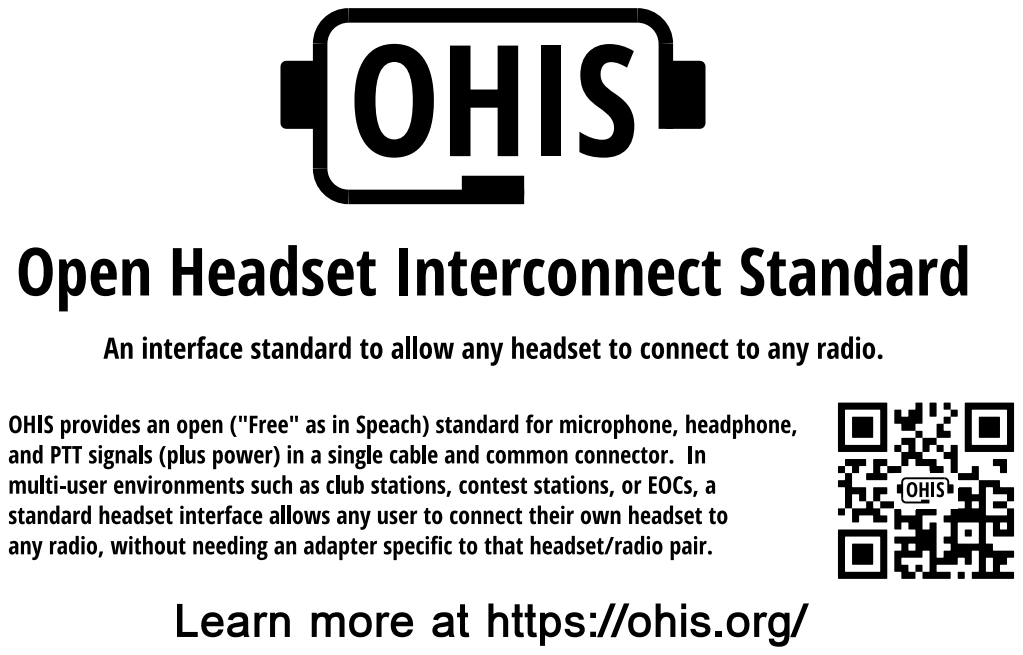
[picture p100: page 1]
