open-headset-interconnect-standard/ohis/KiCAD/MicPreampTest/MicPreampTest.kicad_pcb

## KiCad design KiCAD/MicPreampTest/MicPreampTest.kicad_pcb (2022-08-26)

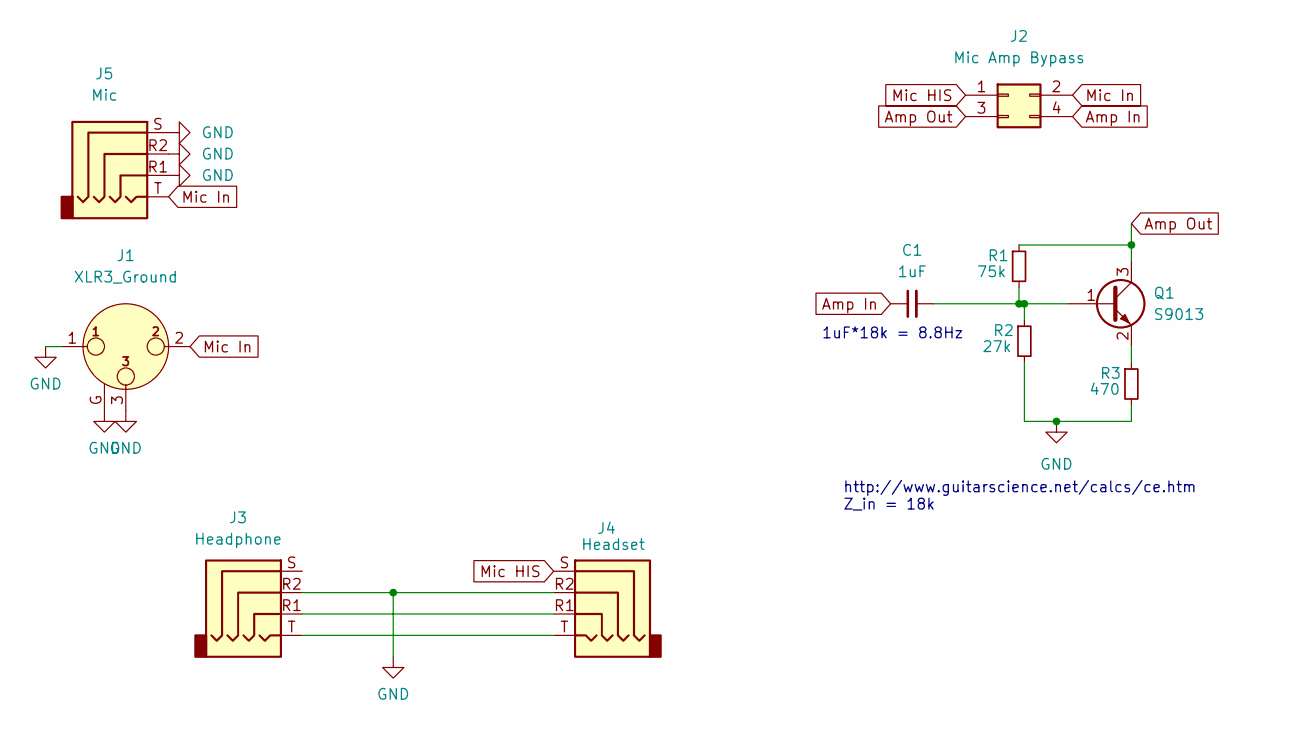
[picture p101: schematic MicPreampTest.kicad_sch]

Parts:
C1: 1uF; C_0603_1608Metric_Pad1.08x0.95mm_HandSolder; LCSC C15849
J1: XLR3_Ground; Jack_XLR_Neutrik_NC3FAAV2-0_Vertical
J2: Mic Amp Bypass; PinHeader_2x02_P2.54mm_Vertical
J3: Headphone; Conn-3.5mm-TRRS-PJ-320L
J4: Headset; Conn-3.5mm-TRRS-PJ-320L
J5: Mic; Conn-3.5mm-TRRS-PJ-320L
Q1: S9013; SOT-23; LCSC C6749
R1: 75k; R_0603_1608Metric_Pad0.98x0.95mm_HandSolder; LCSC C23242
R2: 27k; R_0603_1608Metric_Pad0.98x0.95mm_HandSolder; LCSC C22967
R3: 470; R_0603_1608Metric_Pad0.98x0.95mm_HandSolder; LCSC C23179

Connections:
Amp In: C1.1, J2.4
Amp Out: J2.3, Q1.3 (C), R1.1
GND: J1.1, J1.3, J1.G, J3.R2, J4.R2, J5.R1, J5.R2, J5.S, R2.2, R3.2
Mic HIS: J2.1, J4.S
Mic In: J1.2, J2.2, J5.T
unnamed: C1.2, Q1.1 (B), R1.2, R2.1
unnamed: J3.R1, J4.R1
unnamed: J3.T, J4.T
unnamed: Q1.2 (E), R3.1

Notes on the sheet:
http://www.guitarscience.net/calcs/ce.htm Z_in = 18k
1uF*18k = 8.8Hz

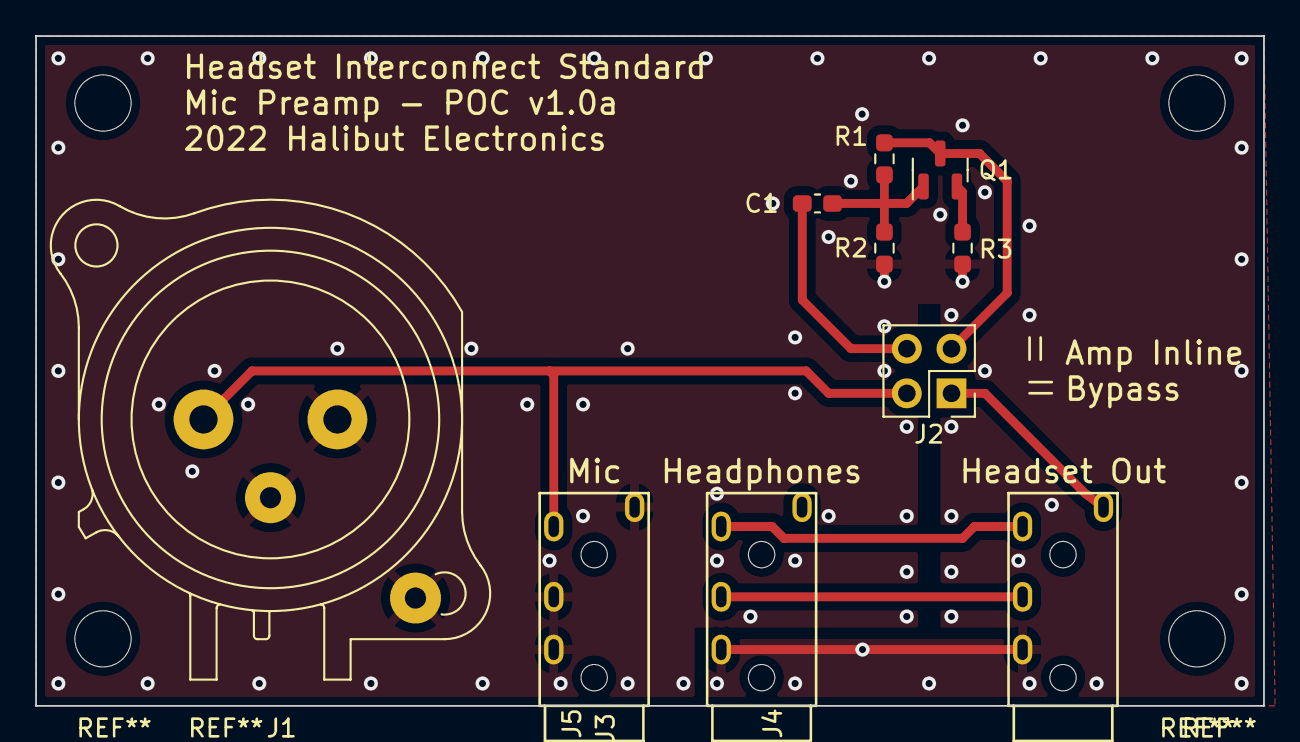
[picture p102: board MicPreampTest.kicad_pcb from above]

Board: 2 copper layers, 69.9 x 38.1 mm, 10 parts (0 on the bottom side), 9 nets.
