open-headset-interconnect-standard/ohis/(commit log)

2022-08-25 https://github.com/Halibut-Electronics/Open-Headset-Interconnect-Standard/issues/1 Started working on the Standard doc. Setup for PDF autogeneration. KiCAD project for drawing things, 'cuz I've got a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
    [Drawings For Standard Doc.kicad_pcb, Drawings For Standard Doc.kicad_sch, Dynamic Mic.kicad_sch, Electret Mic.kicad_sch, Participants.kicad_sch]
2022-08-26 https://github.com/Halibut-Electronics/Open-Headset-Interconnect-Standard/issues/3 Moved KiCAD files from private repo.
    [BOM-MicPreampTest.csv, Drawings For Standard Doc.kicad_pcb, Drawings For Standard Doc.kicad_sch, Dynamic Mic.kicad_sch, Electret Mic.kicad_sch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]
2022-08-26 Added example link to PJ320A 4-pin TRRS sockets used on the board.
    [MicPreampTest.kicad_sch]
2022-08-26 https://github.com/Halibut-Electronics/Open-Headset-Interconnect-Standard/issues/3 Adding Dynamic Mic Preamp circuit.
    [Drawings For Standard Doc.kicad_sch, Mic Preamp.kicad_sch]
2022-08-31 First draft of QSO Today Expo presentation.
    [15dB Pad.kicad_sch, Drawings For Standard Doc.kicad_sch]
2023-01-11 Early versions of an OHIS logo. Not solidified yet. I'll add KiCAD files too.
2023-05-02 Creating generic slide show. Added Overview diagram.
    [Drawings For Standard Doc.kicad_sch, Mic Preamp.kicad_sch, RadioSport to OHIS Cable.ods]
